Nemus-Project/haptic-harpsichord-nime-2025/src/article.tex

\section{Introduction}\label{introduction}

Technological advances have transformed how museums document, present and
interpret their collections. Immersive experiences are realised through tools
such as 3D printing and virtual reality
\cite{allard2005use,Wachowiak01082009,RCM_2024_3D,Kuzminsky_LaserScan_2012,Schaich_3D_2007}.
These technologies form a kind of experiential authenticity, enabling encounters
that evoke the past's sensory, emotional, and intellectual essence
\cite{trant_Auth_1999}. However, as Pine and Gilmore note
\cite{pinegilmore_2007}, achieving authenticity requires museums to navigate the
delicate balance between preservation and meaningful engagement—a challenge that
is particularly evident in the case of historical musical instrument collections
\cite{McAlpine2014}.

Musical instruments represent a peculiar fusion of form, function, and history.
Their cultural value extends beyond their visual appeal to include the tactile
and auditory dimensions of use \cite{Fritz2017}. Yet, preservation concerns
often limit direct interaction, reducing these artefacts to static displays.
This ``red velvet cord'' approach, as theorised by McAlpine \cite{McAlpine2014},
protects fragile mechanisms but diminishes the instruments’ functional identity,
disconnecting visitors from the full richness of their historical and cultural
context.

The \anon{Tagliavini} Collection in \anon{Bologna \cite{Tagliavini2007}}, housed
at \anon{Museo San Colombano - Genus Bononiae} and renowned for its historical
keyboard instruments, exemplifies this dilemma. With over fifty early keyboard
instruments, primarily early plucked stringed keyboards of Italian origin, the
collection stands out as a valuable resource for musicologists, organologists
and musicians alike. Preserving the instruments' authenticity was the
cornerstone of \anon{Ferdinando Tagliavini}’s vision. This guiding principle led
him to collect instruments that could be restored to their playing condition
after minimal intervention.

However, the delicate mechanisms of these instruments and their historical
significance mean they are only played under strict conditions—by experienced
historical keyboard performers or young musicians under strict supervision from
the curator. To enhance accessibility and engagement, the museum commissioned
the replica (Figure \ref{fig:teaser}) of a historical keyboard built in the
tradition of the Italian school, which is the subject of this paper.
The keyboard targets all visitors to the museum, regardless of playing ability,
and can be used without special permission. Jacks that pluck two choirs of muted
strings, across 49-keys, are used to generate MIDI messages that are sent to a
connected computer for audio synthesis. The interface is presently linked to a
commercial software sampler; however, the ultimate aim is to make the sound of
instruments in the collection that can no longer be maintained in playable
condition accessible. Museum visitors are invited to play the interface and
listen through a pair of headphones. This work outlines the technological
aspects of the interface's construction and offers reflections on its role
within the \anon{Tagliavini} Collection and potential application within the
wider musical instrument museum context.

\section{Related Work and Motivations}\label{related-work}

Museums face a constant tension between accessibility and preservation,
restricting how visitors can interact with collections \cite{Templeton2018,
McAlpine2014}. For musical instrument museums, these challenges are compounded
by the difficulty of preserving historical instruments in a playable condition
\cite{McAlpine2014}. The instruments' inherent fragility and gradual decay
inevitably result in a point where they can no longer be played, even when
collections adhere to the strictest conservation protocols \cite{NYT_strad}. A
marked cultural change has taken place in recent decades, shifting the focus
from the playability of the originals to their conservation. Karp
\cite{Karp1979,Karp1985} advocates for a deeper understanding of musical
instruments so that enough knowledge is generated to make them as ``copyable''
as possible.

As part of a broader initiative to enhance accessibility in museums, \anon{the
Museo San Colombano - Tagliavini Collection}, within the cultural itinerary of
\anon{Fondazione Carisbo}, has developed a series of projects aimed at improving
cognitive and sensory access, supported by funding from NextGenerationEU. The
project seeks to leverage the museum’s collection of musical instruments to
create an immersive and interactive engagement with the exhibited heritage. The
reinterpretation of historical musical objects through their tactile and
auditory dimensions is intended to make the exhibition more accessible to blind
and partially sighted visitors. The augmented keyboard aligns with these
objectives, serving as an important component of the initiative to provide
visitors of varying abilities with a hands-on, creative experience within the
museum.

McAlpine discusses a case similar to the \anon{Tagliavini} collection in his
examination of the Benton Fletcher Collection at National Trust Fenton House
\cite{McAlpine2014}. When these instruments were donated, Benton Fletcher
stipulated that they remain playable and should continue to be maintained for
tuition and public performance. A large sampling campaign was conducted, and a
custom MIDI interface was designed to fulfil this requirement while preserving
the original instruments' integrity. The MIDI controller, comprising two
commercially available keyboards mimicking the two-manual harpsichord layout,
was used by visitors to trigger the instrument samples recorded with tailored
strategies for each. However, user tests identified a limitation: the
commercially available weighted keys failed to provide an authentic sense of
interacting with a historical plucked keyboard instrument \cite{McAlpine2014}.

On the other hand, the ``Tromba Moderna'' project \cite{Baldwin2016}, a previous
NIME initiative, approached the issue of musical heritage playability by
recreating and augmenting a replica of a historical tromba marina. A piezo
transducer was connected to a sound synthesis engine and a driver within the
instrument to simulate the expected vibrations of a historical tromba marina.

The keyboard presented here inherits some aspects from the Tromba Moderna
project. The project aims to offer a tool to enhance the visitor experience of
the \anon{Tagliavini} collection while retaining a form of continuity with
historical instrument-building traditions. However, the electronics hidden
inside the interface are not intended to augment or disrupt the tactile
feedback; rather, they serve as the silent and invisible link between the
mechanical and the digital realms.

The optical sensing technique for the keyboard is adapted from a similar project
on the piano by McPherson \cite{McPherson2013}. As such, this project extends
the longevity of the results beyond the scope envisaged in the original works,
enhancing their sustainability, as discussed by Masu \emph{et al.}
\cite{Masu_NIME_2023}. The intended use of the keyboard through meaningful
interaction with a museum exhibit is where the novelty of this work lies, rather
than solely in its technological development.

Besides enhancing the visitor experience, future design iterations will serve as
a research tool to explore the unique characteristics of the harpsichord and its
impact on performance through the \anon{ERC-funded NEMUS} project
\anon{\cite{NEMUS}}, aiming to virtually reproduce the sound of antique keyboard
instruments, and upcoming projects such as Rem@ke \cite{remake1} investigating
embodied relationships between instrument and performer.

\begin{figure*}
  \centering
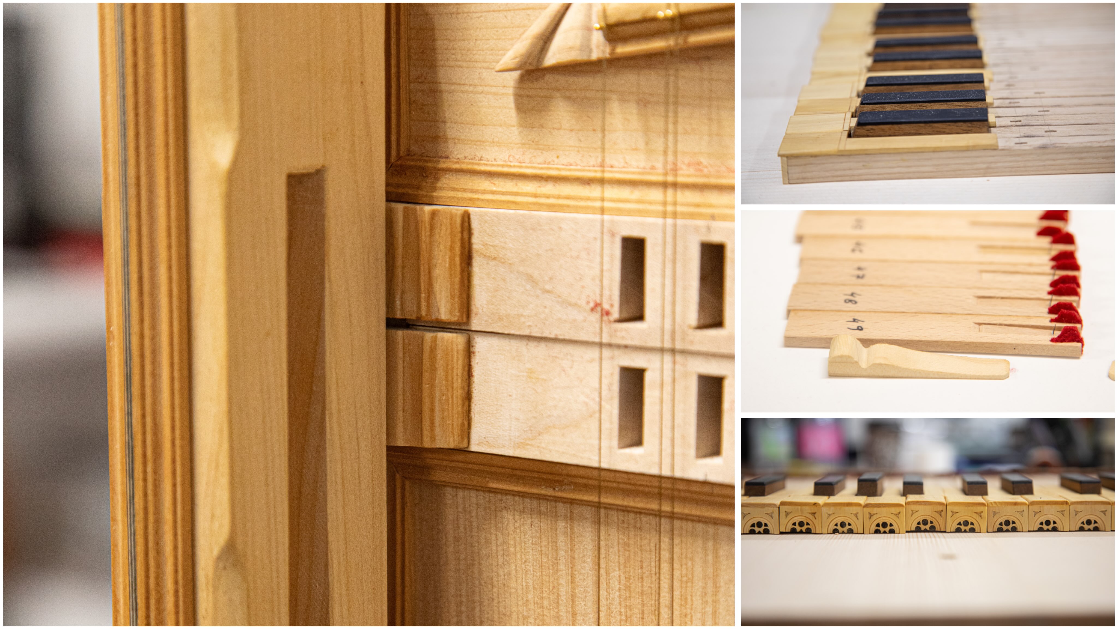
[picture p12: src/images/details.jpg]
  
  \caption{Details of the replica, including the key slots and sides, keys, and jacks with seagull plectra.}
  \Description{4 images contain details of the jack rows. A large image shows
    the end of the jack rows where an extrusion is put to allow jack rows to be
    disengaged. The smaller images show the keys and jack removed from the
    harpsichord exposing the materials from which they are constructed. Shown also
  is the shims for the jack which stop it from easily sliding.}
  \label{fig:details}
\end{figure*}

\section{Design Principles}\label{design}

The design of the augmented replica keyboard for the \anon{Museo San Colombano -
Genus Bononiae} was guided by three principal constraints stipulated by the
museum:

\begin{itemize}
  \item \emph{Faithfulness}. The keyboard mechanism had to ensure fidelity to
    its authentic operation. The electronics system would not seek to `fix' or
    `improve' the limitations of the original design.
  \item \emph{Robustness and reliability}. The system needed to accommodate
    frequent use by museum visitors and allow for straightforward maintenance by
    staff without requiring specialised technical expertise.
  \item \emph{No visible electronic components}. To preserve the visual
    integrity of the exhibit, all electronic components had to remain concealed
    except for a pair of headphones and a small display for audio parameter
    adjustments.
  \item \emph{Reduced use of space}. As museums often face space limitations,
    the instrument needed be compact enough not to compromise space for exhibition
    of the permanent display.
\end{itemize}

These constraints demanded an electronics system that was non-invasive in design
and respectful of the instruments' historical aesthetics. The requirement for
faithfulness to the original mechanism immediately ruled out a mechanical design
reliant on electromechanical actuators, as in previous works on piano haptics
\cite{Timmermans2020,Gillespie1996}. While actuators can generate considerable
force, achieving a jack's free motion and resistance is difficult without
extensive mechanical intervention such as that carried out by Gillespie
\cite{Gillespie1996}.

The final design, shown in Figures \ref{fig:teaser} and \ref{fig:details}, is a
49-key, two-register harpsichord keyboard replica. Since the \anon{Tagliavini
collection} hosts primarily early plucked stringed keyboards of Italian origin,
the keyboard layout was deliberately modelled after early Italian harpsichords,
leveraging the human tendency to be influenced by visual elements when making
musical judgments \cite{Tsay2013}. This effect is particularly relevant in
musical instruments, as demonstrated by studies conducted by Fritz \emph{et al.}
\cite{Fritz2012, Fritz2014, Fritz2017}. Instead of attempting to mitigate this
influence, the design embraces it. This phenomenon, akin to a `musical
instrument McGurk effect’, is one of the reasons why the electronics have been
concealed from view. The aesthetics of the interface enhance its likelihood of
being perceived as an `authentic' musical instrument. Given the extensive
research into modelling and recreating piano action \cite{Cadoz1990,
Gillespie1996, Timmermans2020}, the visual component may provide the final
persuasive element necessary for acceptance, similar to the way visual
perception affects judgments of musical performance \cite{Tsay2013}.

\begin{figure}[!b]
  \centering
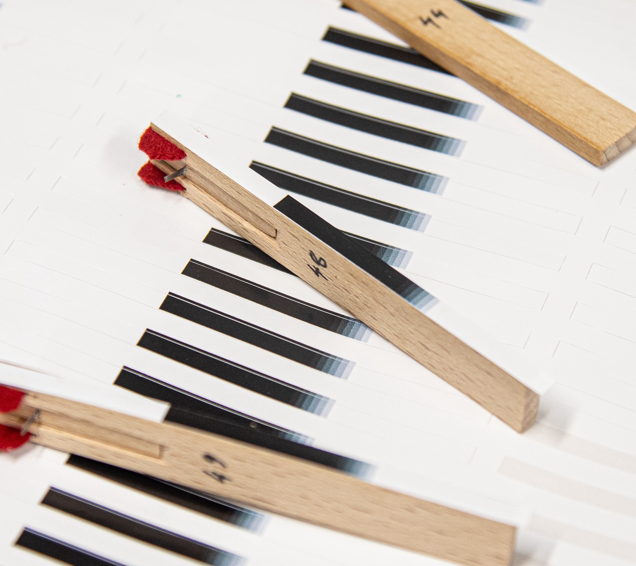
[picture p13: src/images/tagging-jacks-3.jpg]
  
  \caption{Gradient stickers applied to the side of the jack body. The coarse gradient scale was selected to maximise signal excursion while preserving signal readout stability.}
  \Description{Close of two jacks with gradient stickers applied to each. Both
    jack lie on top of the vinyl sheet that was used for printing. The gradient is
    a long black bar that terminates in 7 rectangles of grey over an 8 millimetre
    span. The remainder of the sticker is white. The jacks have the numbers 46 and
    49 written on them at different offset illustrating the numbering system to
  identify their position along the keyboard.}
  \label{fig:jack-tags}
\end{figure}

Optical sensors are positioned in front of each jack and their output voltage
depends on the amount of light reflected from a sensor surface. In this case,
the sensor surface is a grey-scale gradient printed on a vinyl sticker (Figure
\ref{fig:jack-tags}) and applied to the side of each jack. Though the current
configuration simply sends MIDI note-on and -off messages when passing a
threshold, the displacement of all jacks is available continuously. The jacks
for a single key typically have their pluck points offset from each other, a
practice known as `staggering'. A combination of string tension, quill voicing,
and jack staggering contribute to the overall resistance of the action, with
each key differing from the low to the high octaves \cite{Veroli2012}. The
staggering of the pluck point of the jacks between registers means that there
are two distinct tactile anchors along the key dip. The current sensor system
enables the data recording of traditional use from which it can be identified
where those opportunities for new expression lie \cite{McPherson2013-2}.

\begin{figure}
  \centering
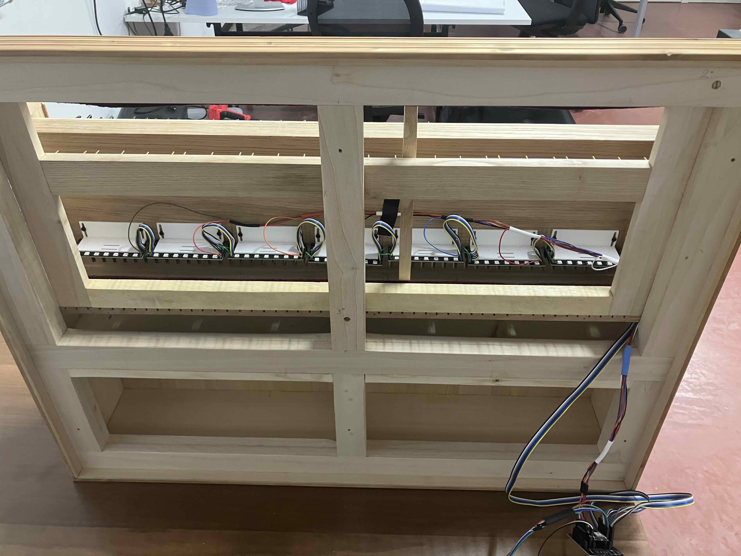
[picture p14: src/images/49-key-bottom-sensors-no-keys.jpg]
  
  \caption{Underside of the full model keyboard, showing two chambers: the front chamber (top) and the rear chamber (bottom).}
  \Description{Underside view of the models with keys removed. A cross brace
    split the case into four quadrants the top two are the front chamber and the
    bottom are the rear chamber. Visible inside are the PCB which are connected to
    each other with multicoloured ribbon cable. From the right 2 long cables, one
    for sensor signals the other for LED and multiplexer signals. Both sets of
    cables terminate at the controller board. The PCBs are attached with white
    plastic supports to the underside of the wrest plank, a thick block of wood in
  which the tuning pegs are screwed.}
  \label{fig:49-key-bottom}
\end{figure}

A modular system of printed circuit boards (PCBs) was designed to manage the
sensors and process their output. The system uses 49 optical sensors distributed
across seven boards containing 7 sensors each. The PCBs were secured to the
underside of the wrest plank and above the keys (Figure
\ref{fig:49-key-bottom}), allowing them to be adjusted during installation.
Ribbon cables connected the PCBs, providing flexibility during assembly while
maintaining a compact form factor. Additional modifications, including baffles
and adhesive improvements, were made to optimise the reliability of the sensor
system during calibration and use.

The project expanded upon earlier NIME research on generating MIDI messages from
piano keystrokes \cite{McPherson2013}, adapting it to address the specific
characteristics of harpsichords. Whereas the previous design emphasised
continuous gesture tracking, this implementation required discrete key-triggered
data to align with the needs of MIDI-triggered audio playback.

\subsection{Materials and Construction}
The keyboard was designed to replicate the tactile and aesthetic sensations of
playing a historical Italian harpsichord. Traditional materials were used,
including walnut for the wrest plank, chestnut for the key levers, boxwood and
ebony for key covers, and cypress for the case and soundboard. The 98 jacks were
made from beech, fitted with brass springs and natural seagull feather plectra.
The design was inspired by the \anon{1547 Alessandro Trasuntino} harpsichord at
the \anon{San Colombano Museum}, considered one of the first prototypes to have
been conceived with two sets of 8-foot strings. An exception was made for the
short octave --- the assigning of common keys in the first octave instead of a
chromatic scale --- typically found in Italian harpsichords, which was replaced
by a standard octave layout to more easily accommodate the interaction with
commercial sample libraries.

% % Option 2
\begin{figure}[!b]
  \centering
  \begin{subfigure}[h]{0.4\linewidth}
    \centering
    \includesvg[inkscapelatex=false, width = \linewidth]{images/log_harp_outline}
    \caption{logarithmic shape}
    \label{fig:log-harp}
  \end{subfigure}

  \begin{subfigure}[h]{0.4\linewidth}
    \centering
    \includesvg[inkscapelatex=false, width = \linewidth]{images/49-key_outline}
    \caption{rectangular shape}
    \label{fig:rect-harp}
  \end{subfigure}
  \caption{Logarithmic shape of an original \anon{Trasuntino} harpsichord
  contrast with the rectangular shape of the replica} \Description{Line drawing
    of two harpsichord shapes. The top line drawing shows the longer tapering form
    of a full scale instrument if it had the same key layout as the replica. The
    second line drawing is of the replica harpsichord. The line drawing share the
    same scale and it can be seen that the replica is roughly one quarter the
  depth of a full scale instrument.}
  \label{fig:log-harp-comp}
\end{figure}

The rectangular poplar frame also deviates from the traditional logarithmic
(Figure \ref{fig:log-harp-comp}) form to allow for the installation of the
electronic sensors, as visible in Figure \ref{fig:49-key-bottom}, without
compromising the visual or tactile authenticity. Two string choirs, crafted from
yellow brass wire and anchored with wrought iron pins, were tensioned to
replicate authentic plucking resistance. Felt strips were added to dampen
vibrations. The result is an interface that combines the mechanical action of
keys with synthetic sound generation, preserving a real harpsichord's tactile
qualities.

\begin{figure}[!t]
  \centering
  
  \caption{ 3-Key Model Harpsichord Mechanism
    %acquired from \anon{San Colombano, Bologna}, 2023.
  } \Description{Side view of a small model mechanism of a harpsichord. The
    model is cut as though it were a cross section of a harpsichord mechanism. The
    Instrument is not to scale and only has a small sound board. Visible are the
    pivots through which the keys are mounted and how the two sets of jack rest on
  the end of the key.}
  \label{fig:3key}
\end{figure}

\subsection{Project Deployment}

A further objective, set forth by the authors, was to ensure reproducibility by
committing to an open source approach for all outputs of the project. The
commitment to open sourcing encompassed all aspects of the system, including
hardware schematics, firmware, and calibration data. Cost-effectiveness was also
a central consideration.
Specifically, the system was designed to be easily assembled using resources
typically available in a university-managed maker space. Components, such as
QRE1113 optical sensors and CD4051BE multiplexers, are widely available from
commercial resellers, while the modular PCB design ensures easy replication and
maintenance. The Arduino Nano was chosen as the core microcontroller format for
its compatibility with open source tools. Calibration workflows were optimised
using the Arduino IDE’s serial plotter and open source MIDI Monitor software
\footnote{\url{https://github.com/krevis/MIDIApps}}, reducing reliance on
proprietary tools and simplifying the process for users.

\begin{anonsuppress}
  Reference repositories for this project can be found here:

  \begin{itemize}
    \item
      \emph{Firmware}:
      \anon{\url{https://github.com/Nemus-Project/harpsichord-interface-firmware}}
    \item
      \emph{PCB CAD}:
      \anon{\url{https://github.com/Nemus-Project/harpsichord-interface-cad}}
    \item
      \emph{Interface Models}:
      \anon{\url{https://github.com/Nemus-Project/harpsichord-interface-models}}
  \end{itemize}
\end{anonsuppress}

\section{Hardware Design}\label{hardware-design}

Figure \ref{fig:system-block-diagram} shows a block diagram of the finalised
hardware setup. The system evolved through iterative prototyping, beginning with
simple threshold-based testing and ending in a fully functional multi-sensor
interface capable of triggering MIDI events.

\subsection{Prototype Stage}

The initial stage of development focused on testing whether sensor data could
reliably trigger MIDI playback. Modifying an existing harpsichord for testing
was considered but ultimately discarded due to significant internal measurement
and layout discrepancies. Instead, a custom 3-key harpsichord mechanism (Figure
\ref{fig:3key}) was used as a foundation for prototyping. This approach followed
a methodology similar to that used in Timmermans \emph{et al.}'s Haptic Key
project \cite{Timmermans2020}, since the 3-key model enabled iterative testing
of individual components, including sensor placement, signal processing, and
mechanical tolerances, before upscaling.

The following criteria were established to guide sensor selection and
integration to make the system suitable for a museum context:

\begin{itemize}
  \item \emph{Non-invasiveness:} No remarkable modifications were allowed on the
    harpsichord mechanics, particularly on all the visible parts.
  \item \emph{Low Latency:} The sampling period for reading and processing data
    from all sensors should remain under 10 ms to allow for latency introduced in
    other parts of the synthesis process. Empirical criteria found in previous
    studies \cite{Jack2016} was used as a guide.
  \item \emph{Reliability:} Sensor data should be dependable and consistent,
    with interference from anything external to the jack movement being absent or
    negligible.
  \item \emph{Scalability:} The design needed to scale in both cost and time in
    order to be adaptable from a 3-key prototype (Figure \ref{fig:3key}) up to the
    49 keys of the final design.    
\end{itemize}

The hardware was designed to make assembly possible in standard university maker
spaces.

\subsection{Sensor Board}\label{sensor-board}

\begin{figure}[!b]
  \centering
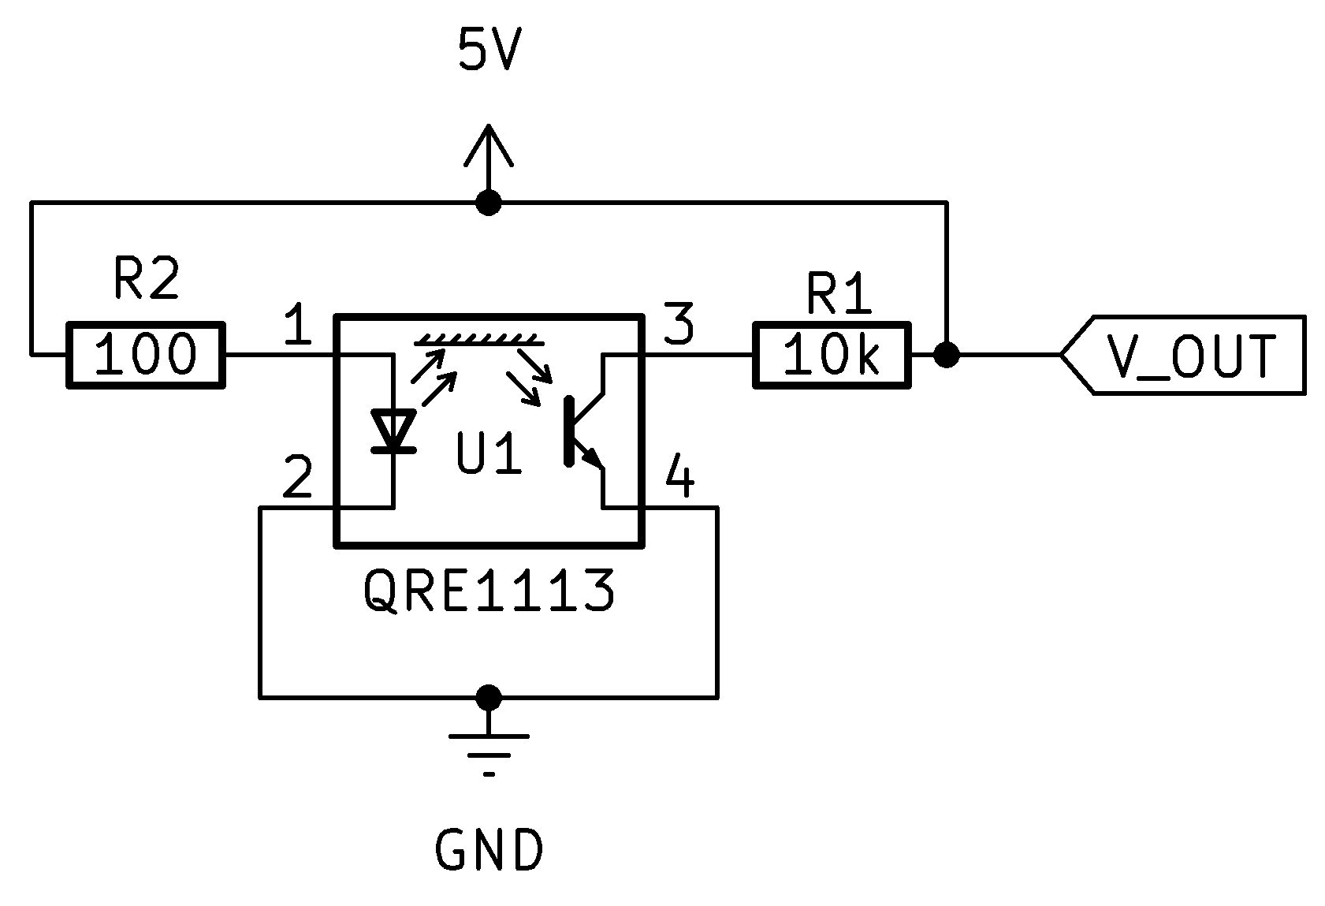
[picture p15: src/images/simple-schematic-bw-.jpg]
  
  \caption{Optical sensor in a simple voltage divider circuit. \texttt{V\_OUT}
  is routed to one of 8 channels on the CD4051BE multiplexer.} \Description{A
    circuit diagram of a voltage divider circuit. The Image shows a 100 ohm
    resistor in line with the LED and a 10 thousand ohm resistor connected to the
    emitter of the phototransistor and the collector connected to ground. The line
    to the bisects before the 10 thousand ohm resistor to a label titled V OUT.
    Arrows from the LED illustrate how light controls the base of the
  phototransistor.}
  \label{fig:simple-schematic}
\end{figure}

The final sensor system utilised QRE1113 optical sensors, known for their small
form factor, low cost, and suitability for short-range distance detection
\cite{McPherson2013, McPherson2019}. The sensors were distributed across seven
printed circuit boards, each responsible for seven keys. Each PCB contained the
following components:

\begin{itemize}
  \item 7 QRE1113 optical sensors.
  \item 7 100 $\Omega$ resistors and 7 10 k$\Omega$ resistors (later reduced to
    one resistor per board).
  \item 1 Texas Instruments CD4051BE multiplexer for signal aggregation.
  \item 7 WS2812 RGB LEDs with integrated driver.
\end{itemize}

\begin{figure*}
  \centering
  
  \caption{Block diagram of PCB connections. A separate sensor signal is routed to the Arduino. LED and multiplexer (MUX) controls signal are daisy-chained through each sensor PCB.}
  \Description{The block diagram shows seven blocks each with sensor board
    written on them. Each sensor block has a solid arrow which connects to a block
    labelled Arduino Nano 33 BLE. A dashed arrow is drawn from the Ardnuino Nano
    33 BLE box and travels through each sensors board. A legend shows the solid
    line represents the flow of the sensor signal and the dashed arrow the flow of
    LED an multiplexer control signals. Angled arrows from the sensor board point
    towards and away from a hatched lined representing the surface of the jacks,
    which illustrates the reflection of light. Lines from boxes labelled FRAM and
  Rotary Encoder point to and from the box labelled Arduino Nano 33 BLE.}
  \label{fig:system-block-diagram}
\end{figure*}

The optical sensors are wired in a voltage divider configuration (Figure
\ref{fig:simple-schematic}) and the circuit outputs a voltage based on the
infrared light reflected from nearby surfaces. The gradient stickers affixed to
each jack provided a surface with varying reflectivity for the sensors, which
were used to track jack displacement throughout the key dip.

\begin{figure}[!t]
  \centering
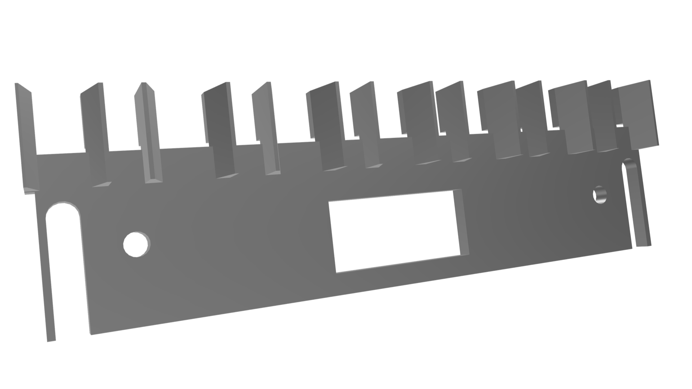
[picture p16: src/images/baffles.png]
  
  \caption{Baffles designed to prevent cross-talk between adjacent sensors.}
  \Description{A 3D model of the baffles used to reduce light leakage. Two slots
    are on the left and right sides. Two holes are visible beside each slot,
    through which the baffles can be attached to the PCB. A rectangular cutaway is
    visible for the multiplexer chip. The baffles contained14 angled extrusions 2
  for each sensor.}
  \label{fig:baffles}
\end{figure}

3D-printed baffles were installed on the PCBs to eliminate cross-talk between
adjacent sensors, as per Figure \ref{fig:baffles}. These baffles, fabricated
from dark-pigmented PLA, ensured that infrared reflections from neighbouring
jacks did not interfere with sensor readings. A manual visual check of plotted
all sensors readings confirmed that interference from neighbouring jacks had
been eliminated. RGB LEDs are placed on the reverse side of the PCB, vertically
in-line with the sensors, and were added to provide a programmable means of
providing visual feedback. The LEDs are controlled via a pulse width modulation
(PWM) signal and are addressable individually. The output signal of the
multiplexer is taken from each PCB and routed to a separate ADC channel of the
Arduino. Multiplexer channel select and LED PWM signals are daisy-chained
through each PCB (Figure \ref{fig:sensor-reverse}).

\subsection{Controller Board}\label{controller-board}

The controller board, designed around the Arduino Nano format, was the central
hub for processing sensor data and triggering MIDI messages. In addition to
solder terminals for the sensor board channels, the controller board contained:

\begin{itemize}
  \item 1 Arduino Nano 33 BLE.
  \item 1 Fujitsu MB85RS64 SPI Ferroelectric RAM chip.
  \item 1 EC11 combined rotary encoder and tactile switch.
    % \item 1 DFROBOT DFR0785 Tactile Switch
\end{itemize}

The Arduino Nano's small form factor made fitting the board inside the
harpsichord easier and also allowed for testing of multiple chipsets. The 33 BLE
variation of the Nano had the additional benefit in its ability to be programmed
as both native USB MIDI and BLE MIDI devices. The 33 BLE was also able to
achieve a sampling period of 1.7 milliseconds for all sensors. A 4-sample moving
average filter was implemented to reduce noise and brought the effective
sampling period to 5.1 milliseconds.

Non-volatile memory, implemented using a Fujitsu MB85RS64 Ferroelectric RAM
(FRAM) chip, provided a reliable means of storing and preserving calibration
settings across power cycles. This ensured that sensor thresholds and other
settings could be preserved across power cycles, enhancing the system's
usability in museums.

A rotary encoder was used as the interface to select a key, edit a threshold and
save current thresholds to the FRAM. Thresholds were first set the midrange of
possible values a a default. A rough calibration process was carried out where
each sensor were selected individually and its readings were plotted against
their current threshold value using the Arduino IDE serial plotter. Thresholds
were adjusted with the rotary encoder until the key no longer passed the
threshold line until the jack had plucked the string. During calibration RGB
LEDs were used as a visual aid to quickly identify which key was currently being
adjusted. These LEDs also provided visual feedback during calibration, and would
change colour based on if readings were above below the threshold or if the were
outside previously recorded maximum or minimum values. Such use of the LEDs
meant for easy identification of malfunctioning sensors and simplified the
alignment process. A finer calibration process was carried out with the guidance
of expert harpsichord performer \anon{Catalina Vicens}.

Power requirements for the system were estimated at 1.1 A at 5 V, with some
fluctuation when the system was first powered on. While the sensors were powered
continuously in this iteration, future designs may incorporate power-saving
measures, such as dynamic modulation of the optical emitters found in the
McPherson piano \cite{McPherson2013}.

\begin{figure}[!b]
  \centering
  
  \\
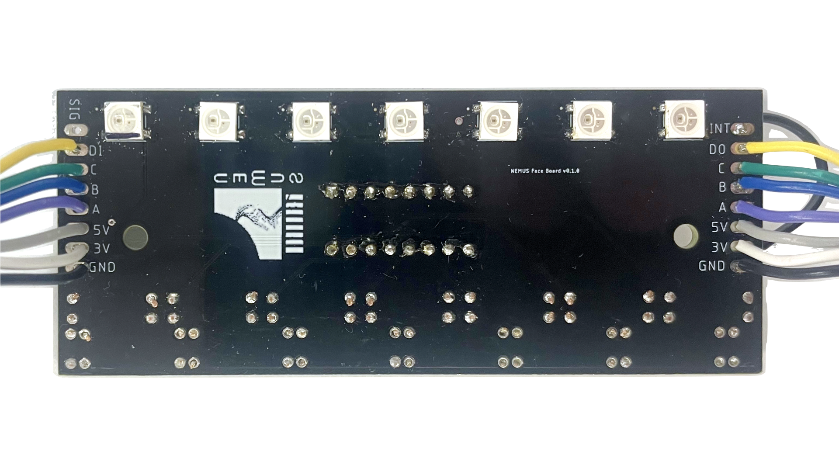
[picture p17: src/images/sensor-board-reverse-side.png]
  
  \caption{Sensor board showing the sensor side (top) and rear side with RGB
    LEDs and terminal connections (bottom). The \texttt{SIG} terminal (Top Left)
    is routed to an ADC channel. Power \texttt{5V, 3V, GND}, multiplexer channels
    \texttt{A, B, C} and LED PWM input \texttt{DI} and output \texttt{DO}  connect
  from the previous sensor board (Left) and are routed to the next (Right).}
  \Description{Two images one of the front and one of the rear of a single
    sensor board. The top image shows the baffles in place and how they enclose
    the field of view of each sensor. The bottom image shows the wires from
    neighbouring circuit boards terminating and the line of 7 RGB LEDs in the same
  spacing as the LEDs.}
  \label{fig:sensor-reverse}
\end{figure}

For the initial version of the exhibition, a harpsichord sample library was used
and controlled via Native Instrument's
Kontakt\footnote{\href{https://www.native-instruments.com/en/products/komplete/samplers/kontakt-8/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}{Kontakt
webpage} (accessed 31 Jan 2025)}. The software was installed on a Mac Mini
hosted inside the instrument's case. Holes were drilled at the back of the
instrument's frame, away from sight, to allow the passage of cables, such as
from power supplies, USB connectors and headphone jack (Figure
\ref{fig:mac-mini}). An iPad is used as a monitor through which visitors can
adjust playback parameters such as tuning, voicing and which stops are engaged.

\begin{figure}
  \centering
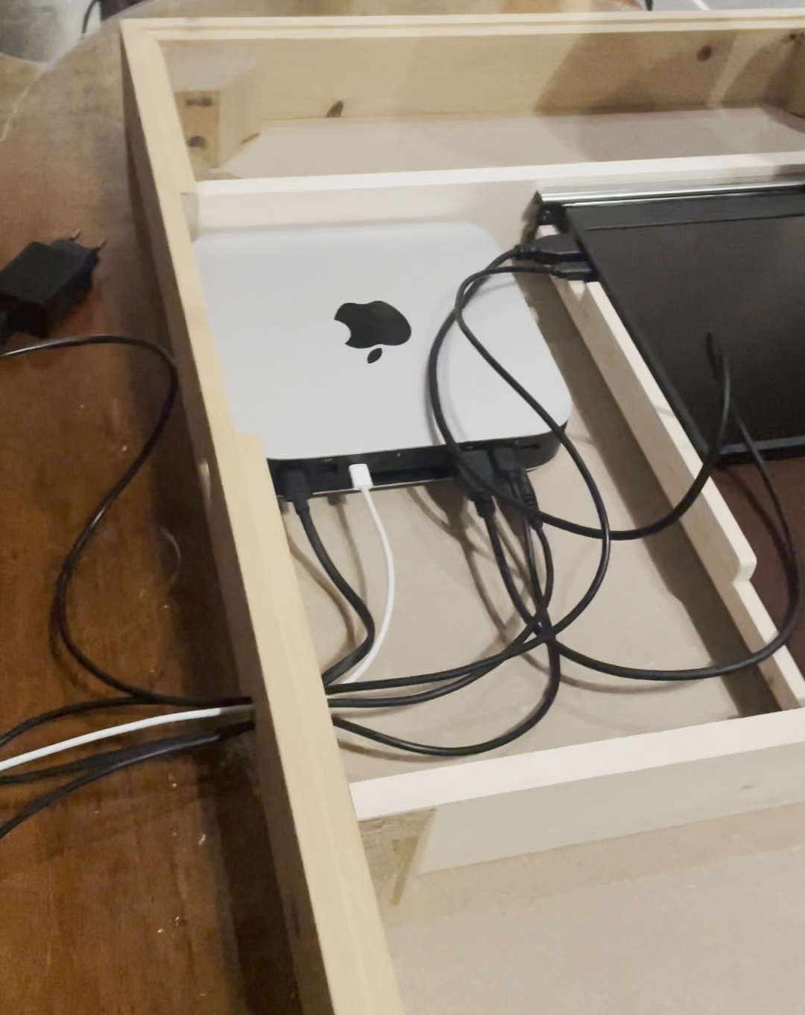
[picture p18: src/images/mac-mini.jpg]
  
  \caption{Components and cabling hidden in the bottom section of the instrument case.}
  \Description{The mac mini and its display fitted in a shallow draw with a
    channel drilled in the end through which cables can be connected. The draw has
  dividers in place to separate the mac mini from the display.}
  \label{fig:mac-mini}
\end{figure}

\section{Discussion}\label{context}

The exhibition is set to open approximately a month after this work's
submission, and only preliminary feedback has been collected from a pool of 20
people -- consisting of staff, surveillance personnel and visitors who were
given training on the system -- and expert feedback from \anon{Catalina Vicens}
and \anon{Roberto Livi}. Visitor feedback was collected through short informal
interviews and primarily to identify technical problems. The keyboard shows
promise in enhancing the museum experience as comments about a ``sense of
disconnect'' found in the Benton Fletcher Collection \cite{McAlpine2014} were
absent in this initial feedback.

A more formal surveying of museum visitors would be required to determine to
what degree the exhibition achieved its core aims. The keyboard is hosted in the
\emph{Oratory} above the museum's main hall, an exceptional testimony to the
Bolognese art, decorated by the finest students of the Carracci and presenting a
series of frescoes covering most of the walls and ceiling. The room hosts unique
examples of the Italian Renaissance building tradition, including the 1547
harpsichord and the 1540 spinet by \anon{Alessandro Trasuntino}. Visitors often
visit the room with the same caution and respect typical of worship spaces.
Among the visitors interviewed, no comments were made that the exposed
headphones and touchscreen affected such an experience negatively, though a more
definitive answer will come as more feedback is collected after launch. Pictures
of the keyboard hosted in the \emph{Oratory} are shown in Figure
\ref{fig:oratory}.

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

\begin{figure}
  \centering
  
  \caption{The keyboard installed in the \emph{Oratory} at \anon{San Colombano},
  and a user wearing headphones playing it.} \Description{2 images on showing
    the keyboard in situ in the museum and the second a user playing the keyboard.
    The harpsichord placed on top the drawer in which the mac mini and display
    reside. The whole harpsichord unit is positioned on a table. The right image
    shows a user standing playing the keyboard with a display for the exhibition
  visible in the background.}
  \label{fig:oratory}
\end{figure}

This work has incorporated and developed further the ideas of reusing and
complimenting the `old' in digital musical instrument design as put forward in
the article `The \emph{O} in NIME' \cite{Masu_NIME_2023}. By integrating
historical keyboard-building traditions with digital augmentation, it offers a
possibility to extend the practical lifespan of musical heritage while
maintaining the tactile qualities of the original instrument. Rather than
prioritising technical novelty, the project demonstrates how digital
interventions can support multi-modal interaction with a shared musical
heritage, ensuring its continued relevance in contemporary museum contexts.

A longer discussion, but one going beyond the scope of this work, is whether the
current setup or its future iterations may be effectively used to build
legitimate replicas of historical musical instruments or even become a kind of
\emph{new} musical instrument altogether. As such, the question is whether these
designs may result in music being practised, performed and recorded with the
instruments. This work supports an overarching narrative extending beyond its
application in museum collections. The \anon{NEMUS project \cite{NEMUS}},
focusing on developing advanced physical models simulating the non-linear
interaction between subcomponents, has commissioned a second keyboard to further
explore the role of control interfaces in performance, employing the sense of
touch as link between the mechanical world with the digital, replicating the
embodied relationships between performer and instrument and offering
opportunities to modify or even disrupt these interactions. The upcoming Rem@ke
project \cite{remake1} has also expressed an interest in engaging with the
keyboard to explore meaningful embodied interactions between players and
instruments.
