Nemus-Project/haptic-harpsichord-nime-2025/src/main.tex

%%
%% This is file `sample-nime-paper.tex',
%% generated with the docstrip utility.
%%
%% The original source files were:
%%
%% samples.dtx  (with options: `all,proceedings,bibtex,sigconf')
%% 
%% IMPORTANT NOTICE:
%% 
%% For the copyright see the source file.
%% 
%% Any modified versions of this file must be renamed
%% with new filenames distinct from sample-nime-paper.tex.
%% 
%% For distribution of the original source see the terms
%% for copying and modification in the file samples.dtx.
%% 
%% This generated file may be distributed as long as the
%% original source files, as listed above, are part of the
%% same distribution. (The sources need not necessarily be
%% in the same archive or directory.)
%%
%%
%% Commands for TeXCount
%TC:macro \cite [option:text,text]
%TC:macro \citep [option:text,text]
%TC:macro \citet [option:text,text]
%TC:envir table 0 1
%TC:envir table* 0 1
%TC:envir tabular [ignore] word
%TC:envir displaymath 0 word
%TC:envir math 0 word
%TC:envir comment 0 0
%%
%%
%% History of NIME Template Updaters:
%% Modified by Florent Berthaut, Charles Martin, Yichen Wang, 21 November 2024
%% Modified by Adnan Marquez-Borbon 30 November 2022
%% Modified by Courtney Reed 28 November 2022
%% Modified by Joe Wright 14 December 2019
%% Modified by Niccolò Granieri 10 October 2018
%% Modified by Angelo Fraietta 23 December 2018
%% Modified by Angelo Fraietta 22 November 2018
%% Modified by Rodrigo Schramm on 22 September 2018
%% Modified by Luke Dahl on 17 October 2-17
%% Modified by Cumhur Erkut on <2016-10-11 Tue>
%% Modified by Edgar Berdahl on 5 November 2014
%% Modified by Baptiste Caramiaux on 25 November 2013
%% Modified by Kyogu Lee on 7 October 2012
%% Modified by Georg Essl on 7 November 2011
%%
%% And here's the template:
%%
%% The first command in your LaTeX source must be the \documentclass
%% command.
%%
%% For submission and review of your manuscript please change the
%% command to \documentclass[manuscript, screen, review]{nimeart}.
%%
%% When submitting camera ready or to TAPS, please change the command
%% to \documentclass[sigconf]{nimeart} or whichever template is required
%% for your publication.
%%
%%
% \documentclass[sigconf]{nimeart}
% \documentclass[sigconf]{nimeart}
\documentclass[sigconf]{nimeart}
\usepackage{graphicx,subcaption,svg}

%%
%% \BibTeX command to typeset BibTeX logo in the docs
\AtBeginDocument{%
  \providecommand\BibTeX{{%
    Bib\TeX}}}

%% Rights management information.  This information is sent to you
%% when you complete the rights form.  These commands have SAMPLE
%% values in them; it is your responsibility as an author to replace
%% the commands and values with those provided to you when you
%% complete the rights form.
\setcopyright{cc}
\copyrightyear{2025}
\acmYear{2025}
\acmDOI{}
%% These commands are for a PROCEEDINGS abstract or paper.
%% Make sure this is up to date with the correct edition of NIME.
\acmConference[NIME '25]{International Conference on New Interfaces for Musical Expression}{June 24--27,
  2025}{Canberra, Australia}
%% This suppresses the ACM Reference Format printing.
\settopmatter{printacmref=false}
%%
%%  Uncomment \acmBooktitle if the title of the proceedings is different
%%  from ``Proceedings of ...''!
%%
%%\acmBooktitle{Woodstock '18: ACM Symposium on Neural Gaze Detection,
%%  June 03--05, 2018, Woodstock, NY}
\acmISBN{}

%%
%% Submission ID.
%% Use this when submitting an article to a sponsored event. You'll
%% receive a unique submission ID from the organizers
%% of the event, and this ID should be used as the parameter to this command.
%%\acmSubmissionID{123-A56-BU3}

%%
%% For managing citations, it is recommended to use bibliography
%% files in BibTeX format.
%%
%% You can then either use BibTeX with the ACM-Reference-Format style,
%% or BibLaTeX with the acmnumeric or acmauthoryear sytles, that include
%% support for advanced citation of software artefact from the
%% biblatex-software package, also separately available on CTAN.
%%
%% Look at the sample-*-biblatex.tex files for templates showcasing
%% the biblatex styles.
%%

%%
%% The majority of ACM publications use numbered citations and
%% references.  The command \citestyle{authoryear} switches to the
%% "author year" style.
%%
%% If you are preparing content for an event
%% sponsored by ACM SIGGRAPH, you must use the "author year" style of
%% citations and references.
%% Uncommenting
%% the next command will enable that style.
%%\citestyle{acmauthoryear}

%%
%% end of the preamble, start of the body of the document source.
\begin{document}

%%
%% The "title" command has an optional parameter,
%% allowing the author to define a "short title" to be used in page headers.
\title{Augmentation of a Historical Harpsichord Keyboard Replica for Haptic-Enabled Interaction in Museum Exhibitions}

%%
%% The "author" command and its associated commands are used to define
%% the authors and their affiliations.
%% Of note is the shared affiliation of the first two authors, and the
%% "authornote" and "authornotemark" commands
%% used to denote shared contribution to the research.
\author{Matthew Hamilton}
% \authornote{Both authors contributed equally to this research.}
\affiliation{%
  \institution{Università di Bologna}
  \city{Bologna}  
  \country{Italy}
}
\email{matthew.hamilton2@unibo.it}
% \orcid{1234-5678-9012}
\author{Michele Ducceschi}
% \authornotemark[1]
\affiliation{%
  \institution{Università di Bologna}
  \city{Bologna}  
  \country{Italy}
}
\email{michele.ducceschi@unibo.it}

\author{Roberto Livi}
\affiliation{%
  \institution{Master Harpsichord Maker}
  \city{Pesaro}
  \country{Italy}
  }
\email{robertvs.livi@gmail.com}

\author{Catalina Vicens}
\affiliation{%
  \institution{Museo San Colombano}
  \city{Bologna}
  \country{Italy}}
  \email{catalina.vicens@genusbononiae.it}

\author{Andrew McPherson}
\affiliation{%
 \institution{Imperial College London}
 \city{London}
 \country{United Kingdom}}
 \email{andrew.mcpherson@imperial.ac.uk}

%%
%% By default, the full list of authors will be used in the page
%% headers. Often, this list is too long, and will overlap
%% other information printed in the page headers. This command allows
%% the author to define a more concise list
%% of authors' names for this purpose.
% \renewcommand{\shortauthors}{Hamilton et al.}

%%
%% The abstract is a short summary of the work to be presented in the
%% article.
\begin{abstract}
% This paper describes the design and creation of an electronically augmented replica of a 16th-century harpsichord keyboard with a typical Renaissance Italian layout to create a digital musical instrument. % [1]
% The tactile feedback of the keyboard is created by incorporating the same mechanics as a single manual two-register harpsichord with strings under tension in order to replicate the mechanical resistance characteristic of the original compass. % [1]
% An optical sensor system was fitted inside the body of the harpsichord, directed towards a gradient surface applied to the body of each jack, generating continuous streams of data corresponding that are used to trigger a sample library. % [1, ~4]
% The keyboard was commissioned for exhibition in a musical instrument museum as an enhancement to the visitor experience by providing means of accessing to instruments that are no longer in playing condition. % [2]
% The details of the keyboard's design principles, technical development, and underlying motivations are described in detail. % [1]
% % The design and mechanics of a harpsichord were replicated in the new keyboard as using modern plastic MIDI controllers has been shown to be an unsatisfying experience for users. % [3]
% % This culminated in a design for a keyboard interface capable of extending the performance techniques of the harpsichord. % [4]

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

\end{abstract}

%%
%% Keywords. The author(s) should pick words that accurately describe
%% the work being presented. Separate the keywords with commas.
\keywords{interactive exhibit, augmented instrument, optical sensing, harpsichord}

%% A "teaser" image appears between the author and affiliation
%% information and the body of the document, and typically spans the
%% page.

% % Option 1:
% \begin{teaserfigure}
%   \includegraphics[width=\textwidth]{images/49-key-front.png}
%   \caption{49-key Model Harpsichord Mechanism by Roberto Livi, Bologna 2024}
%   \Description{49-key Model Harpsichord Mechanism by Roberto Livi, Bologna 2024}
%   \label{fig:teaser}
% \end{teaserfigure}

% Option 2:
\begin{teaserfigure}
 \centering
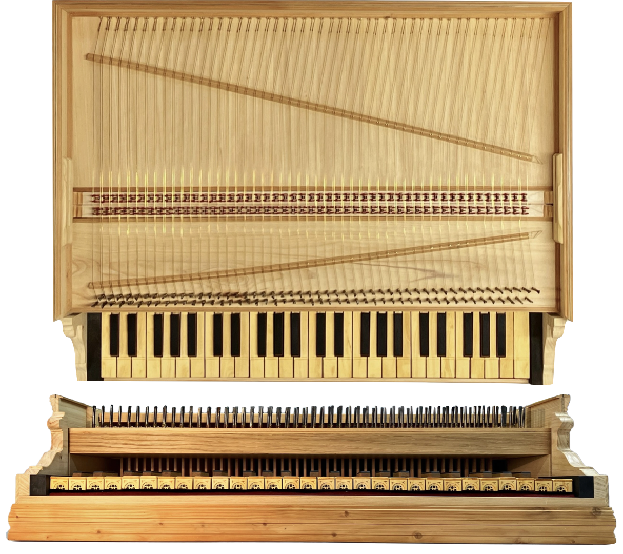
[picture p20: src/images/49-key-front-top.png]
  
  \caption{49-key Model Harpsichord Mechanism by \anon{Roberto Livi, Bologna 2024}}
  \Description{An overhead and front view of the replica harpsichord. The overhead view shows the exposed jacks rows, 49 per row and the slant of the bridge and change of sctring from the left to the right.
The front view shows arch detailing on the edge of each key in the same style as is found on early Italian harpsichords.}
  \label{fig:teaser}
\end{teaserfigure}

% % Option 3:
% \begin{teaserfigure}
%   \includegraphics[width=\textwidth]{src/images/sensors-without-keys-front.jpg}
%   \caption{49-key Model Harpsichord Mechanism by Roberto Livi, Bologna 2024}
%   \Description{49-key Model Harpsichord Mechanism by Roberto Livi, Bologna 2024}
%   \label{fig:teaser}
% \end{teaserfigure}

%% Placeholder
% \begin{teaserfigure}
%   \includegraphics[width=\textwidth]{images/side_w-o_sensors.png}
%   \caption{3-key Model Harpsichord Mechanism by Graziano Bandini, Bologna 2023}
%   \Description{3-key Model Harpsichord Mechanism by Graziano Bandini, Bologna 2023}
%   \label{fig:teaser}
% \end{teaserfigure}

%%
%% This command processes the author and affiliation and title
%% information and builds the first part of the formatted document.
\maketitle

\include{src/article}

%%
%% The acknowledgments section is defined using the "acks" environment
%% (and NOT an unnumbered section). This ensures the proper
%% identification of the section in the article metadata, and the
%% consistent spelling of the heading.

\begin{acks}
The construction of the keyboard received funding from NextGenerationEU within the framework of the accessibility project for the Removal of Physical and Cognitive Barriers in Museums, Libraries and Archives: Sound Heritage No Limits, in the Museum of San Colombano in Bologna - CUP: C38J23000040001 - in the context of PNRR, Mission 1. MH and MD's work was supported by the European Commission's Horizon2020 programme through grant \anon{ERC-StG 950084 NEMUS}. 

 We acknowledge the invaluable contributions of
\begin{itemize}
\item
  Università di Bologna
  \begin{itemize}
  \item
    \emph{Alma Labor}:
      Massimiliano Fraulini and the staff of Alma Labor at the Università
      di Bologna for their 3D printing expertise and generosity with
      electronics equipment
  \item
    \emph{Fisica Tecnica}: Maurzio Chendi, Fabrizio Casarini, Giulio Severo and Barbara
      Costantini    
  \end{itemize}
\item
  University of Edinburgh
  \begin{itemize}
  \item
    \emph{uCreate}:    
      Simeon, Stuart, Izzy, and Ruth of uCreate at the Univeristy of
      Edinburgh for their support with soldering facilities.    
  \item
    \emph{Edinburgh College of Art}: Richard Collins and the Digital Making Staff at the Edinburgh
      College of Art for 3D printing instruction and CNC support. Digital Development Technician Joe Hathaway    
    \item  
      \emph{St Cecilia's}: Curator Dr. Jenny Nex
  \end{itemize}
\end{itemize}

\end{acks}

\section{Ethical Standards}
This work is an empirical study of a keyboard system and
involved no research participants. The authors obtained explicit consent to collect feedback. Seagull feathers, employed as a building material for the jacks, were ethically sourced and collected along the Pesaro coastline. 

%%
%% The next two lines define the bibliography style to be used, and
%% the bibliography file.
\bibliographystyle{ACM-Reference-Format}
\bibliography{main}

\end{document}
\endinput
%%
%% End of file `sample-nime-paper.tex'.
