Nemus-Project/haptic-harpsichord-nime-2025/src/images/outline_compare.pdf

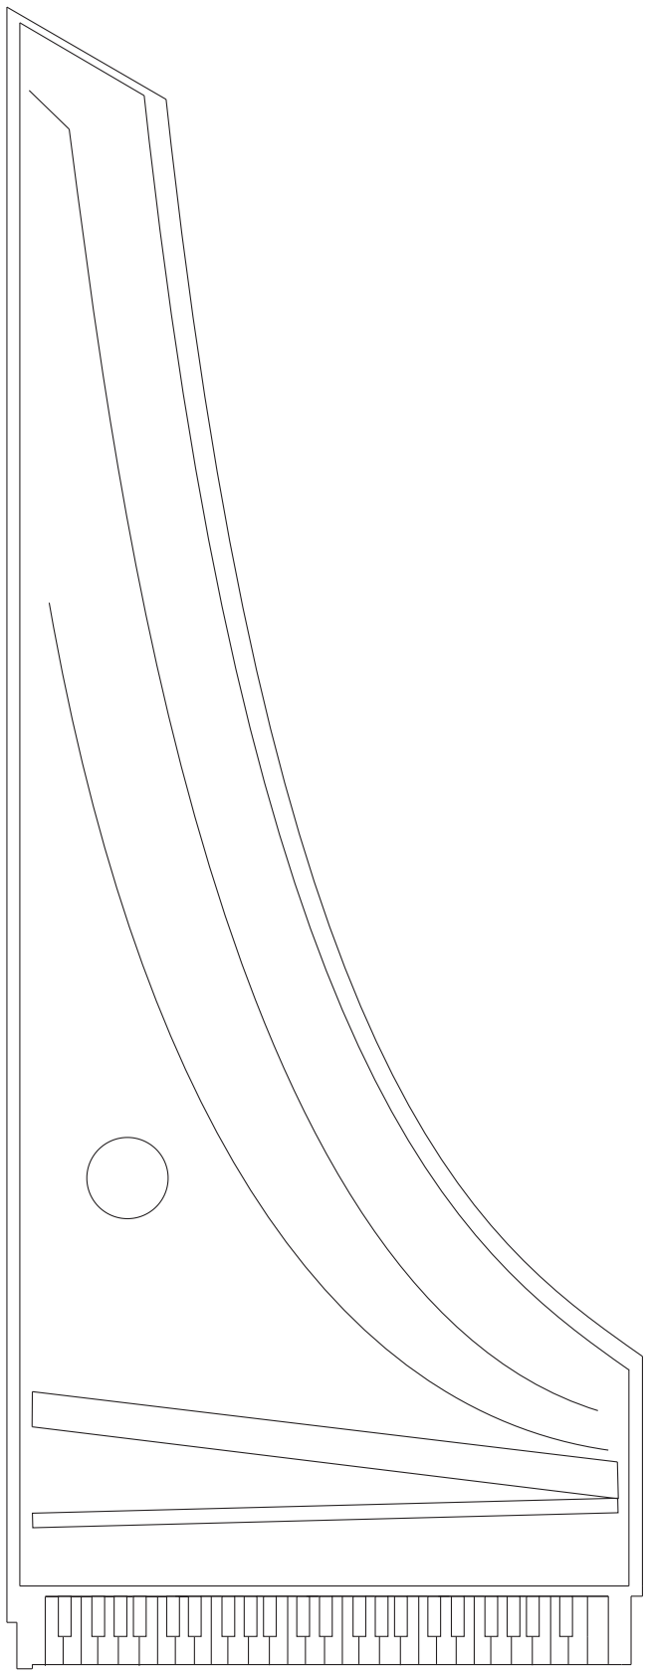
[picture p21: figure]
