Nemus-Project/haptic-harpsichord-nime-2025/src/images/3-key-jacks-w-tags.jpg

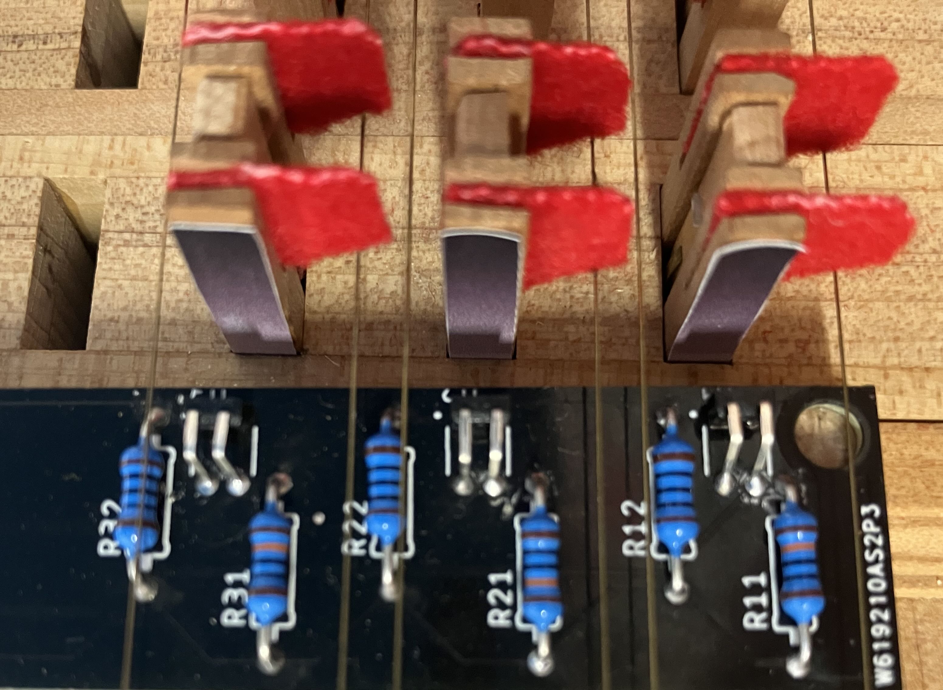
src/images/3-key-jacks-w-tags.jpg
