Nemus-Project/haptic-harpsichord-nime-2025/src/images/3-key-side-labelled.png

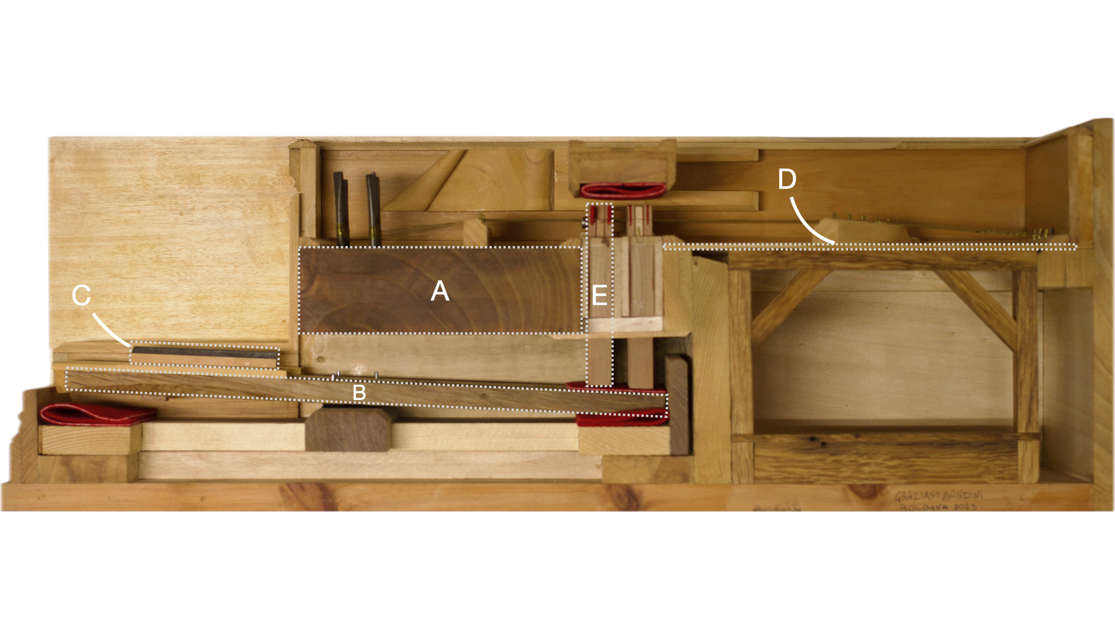
src/images/3-key-side-labelled.png
