Nemus-Project/haptic-harpsichord-nime-2025/src/images/3-sensor-schematic.png

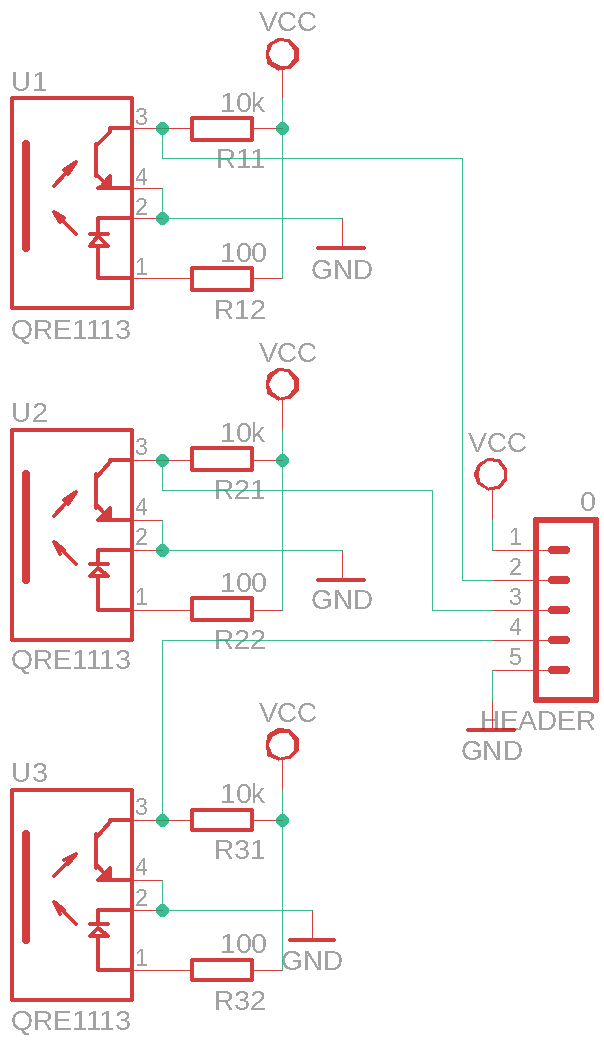
src/images/3-sensor-schematic.png
