Nemus-Project/haptic-harpsichord-nime-2025/src/images/7-sensor-board-v0.1.0.png

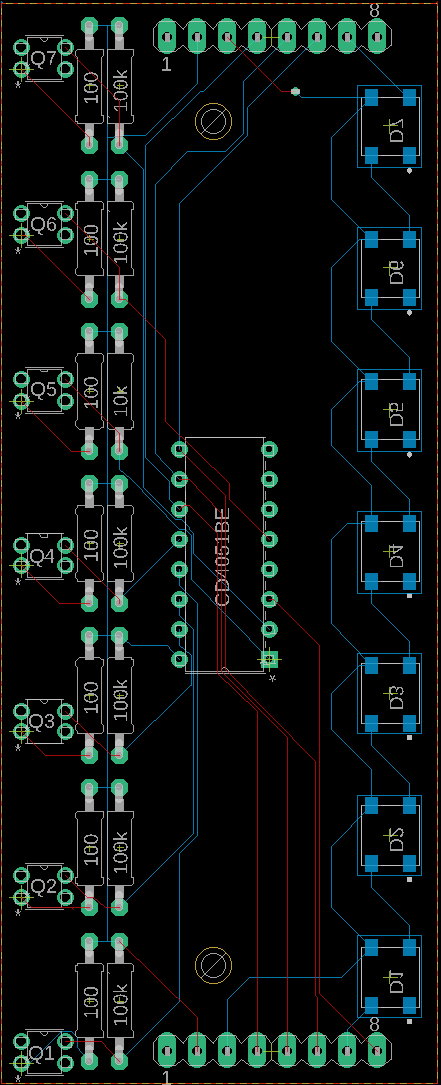
src/images/7-sensor-board-v0.1.0.png
