Nemus-Project/haptic-harpsichord-nime-2025/src/images/49-key-bottom.jpeg

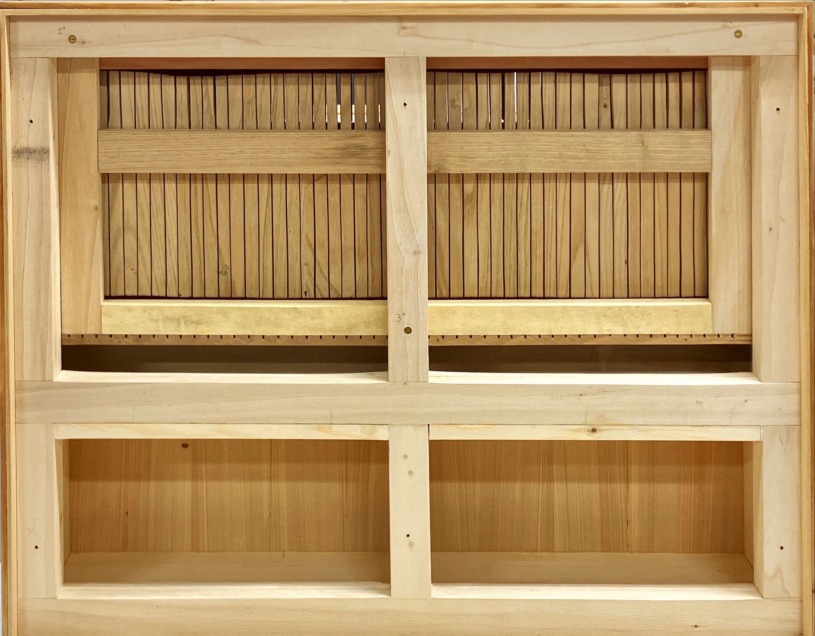
src/images/49-key-bottom.jpeg
