Nemus-Project/haptic-harpsichord-nime-2025/src/images/49-key-front.JPG

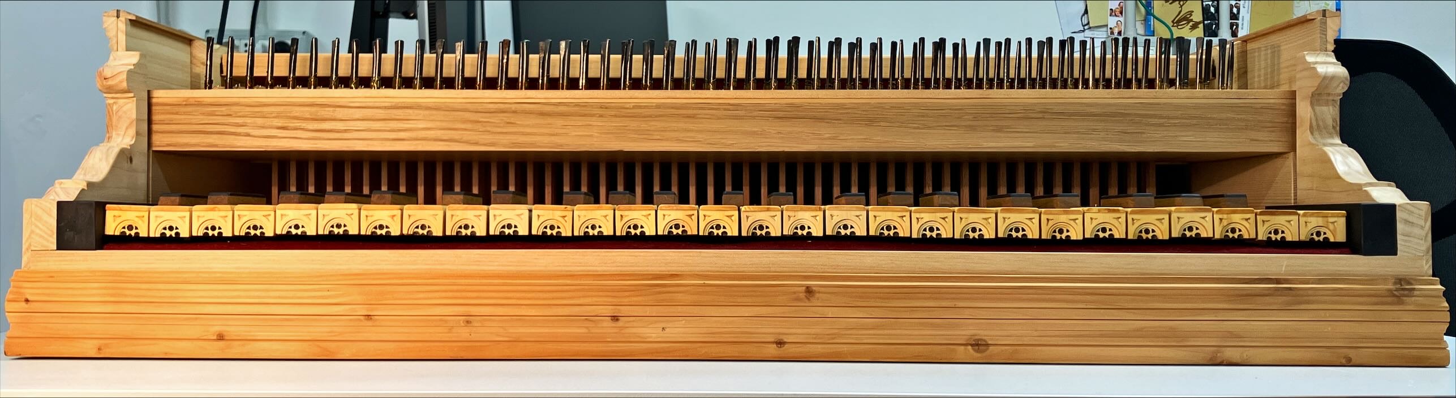
src/images/49-key-front.JPG
