Nemus-Project/haptic-harpsichord-nime-2025/src/images/49-key-leds.png

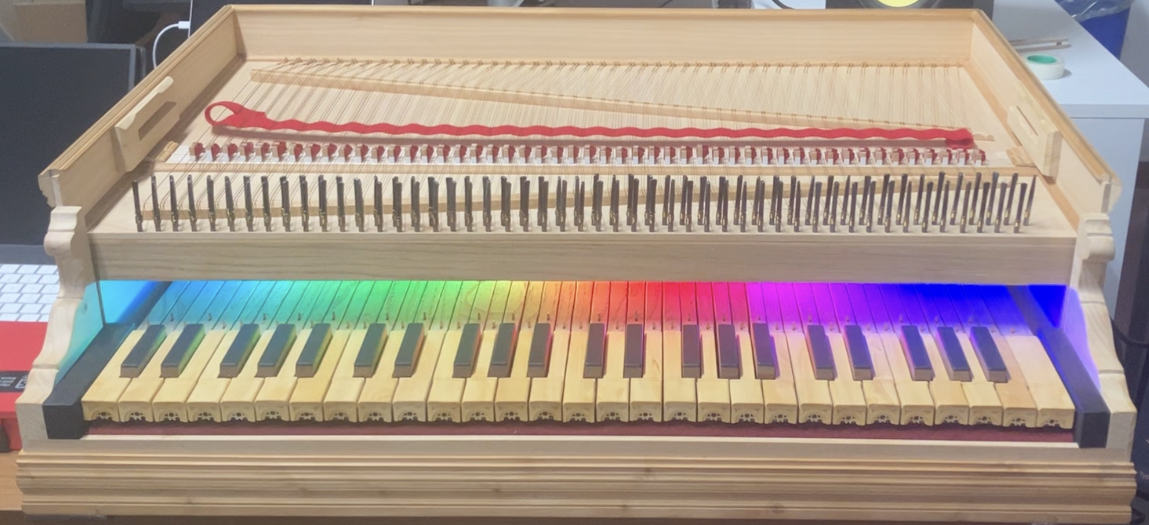
src/images/49-key-leds.png
