Nemus-Project/haptic-harpsichord-nime-2025/src/images/controller-board-v0.1.0.png

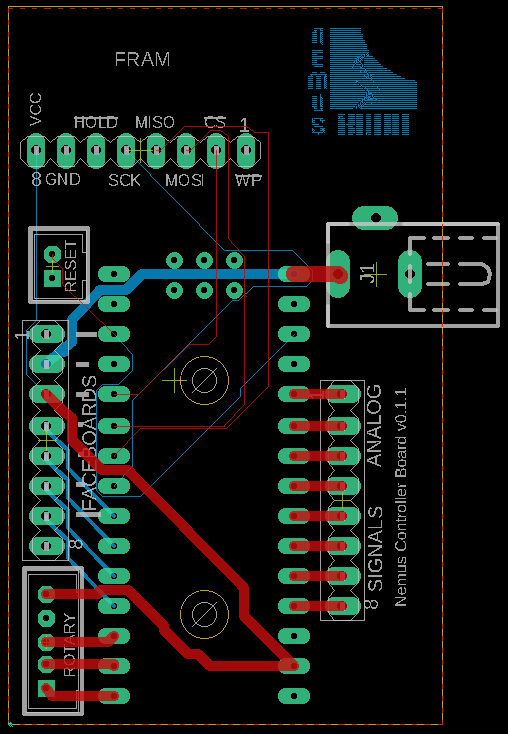
src/images/controller-board-v0.1.0.png
