Nemus-Project/haptic-harpsichord-nime-2025/src/images/exhibition-user-1.jpeg

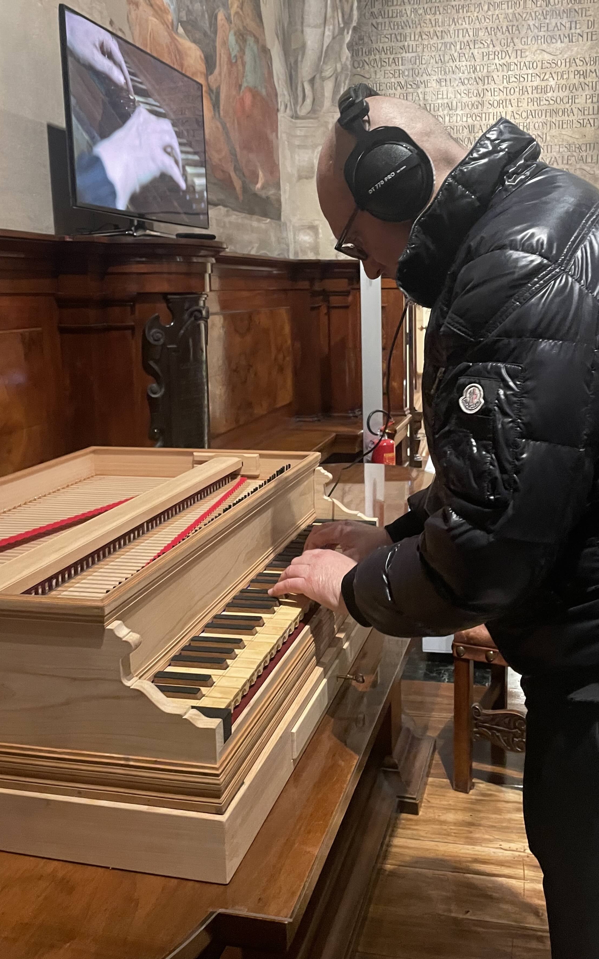
src/images/exhibition-user-1.jpeg
