Nemus-Project/haptic-harpsichord-nime-2025/src/images/exhibition-user-2.jpg

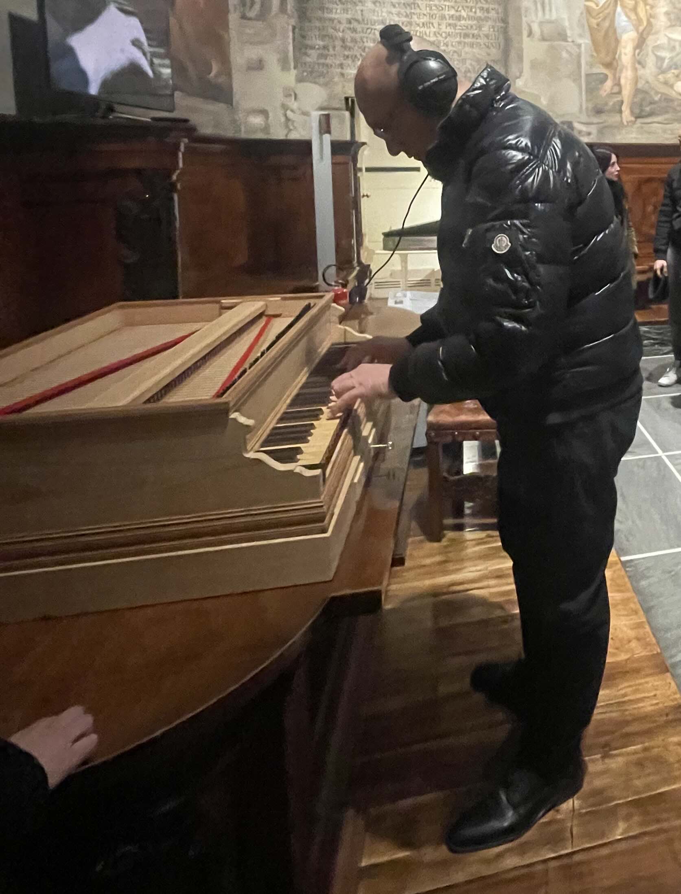
src/images/exhibition-user-2.jpg
