Nemus-Project/haptic-harpsichord-nime-2025/src/images/jack-w-tag.jpeg

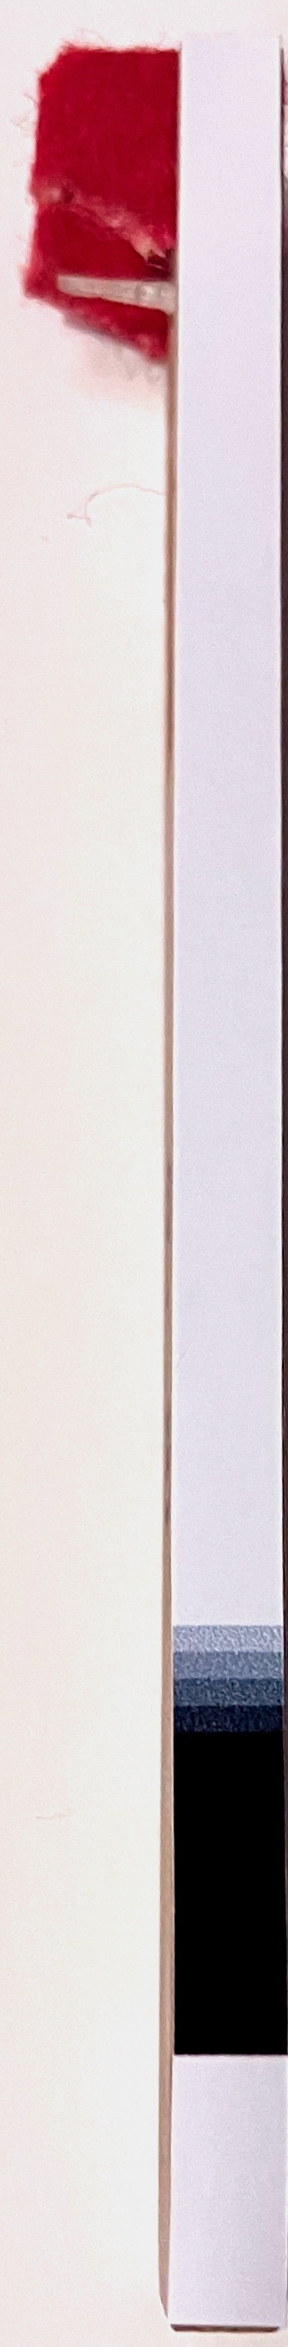
src/images/jack-w-tag.jpeg
