Nemus-Project/haptic-harpsichord-nime-2025/src/images/key_milling_area.jpg

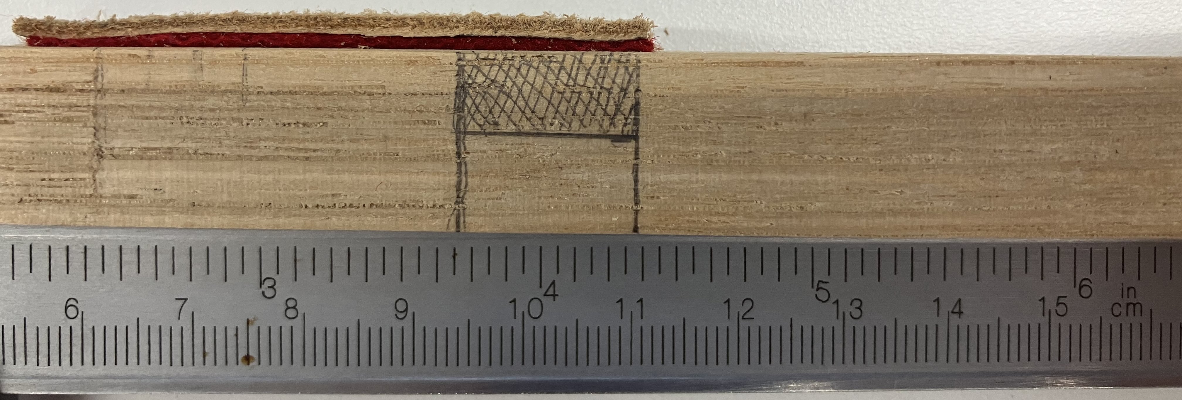
src/images/key_milling_area.jpg
