Nemus-Project/haptic-harpsichord-nime-2025/src/images/keys-milled.jpeg

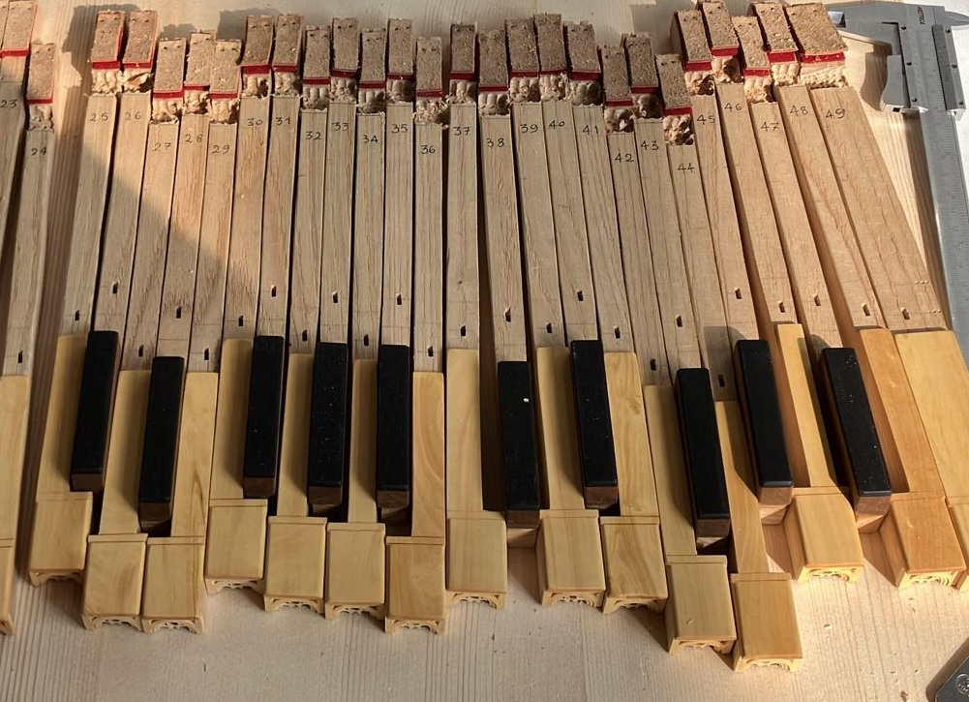
src/images/keys-milled.jpeg
