Nemus-Project/haptic-harpsichord-nime-2025/src/images/milled-keys.jpg

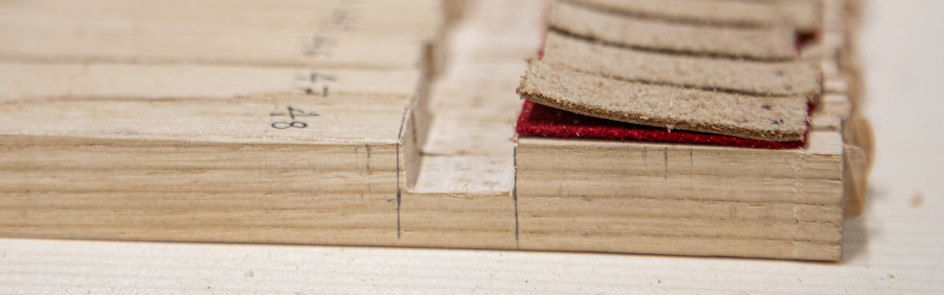
src/images/milled-keys.jpg
