Nemus-Project/haptic-harpsichord-nime-2025/src/images/sensor-board-baffles.jpeg

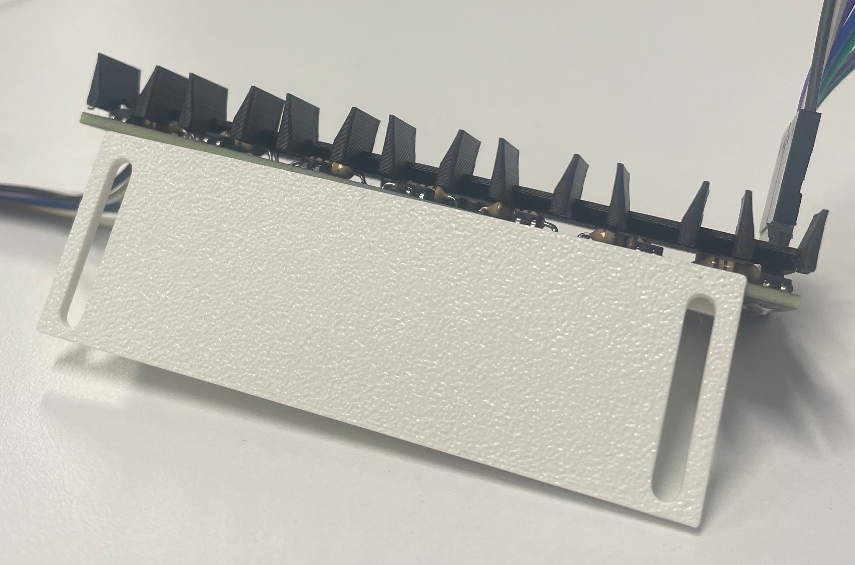
src/images/sensor-board-baffles.jpeg
