Nemus-Project/haptic-harpsichord-nime-2025/src/images/sensor-board-reverse-side-anon.png

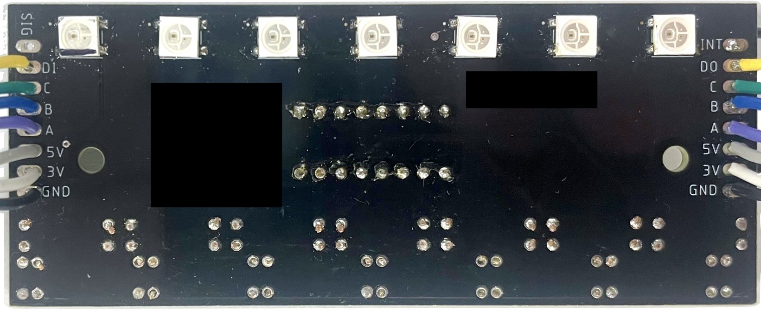
src/images/sensor-board-reverse-side-anon.png
