Nemus-Project/haptic-harpsichord-nime-2025/src/images/sensor-board-reverse-side.jpeg

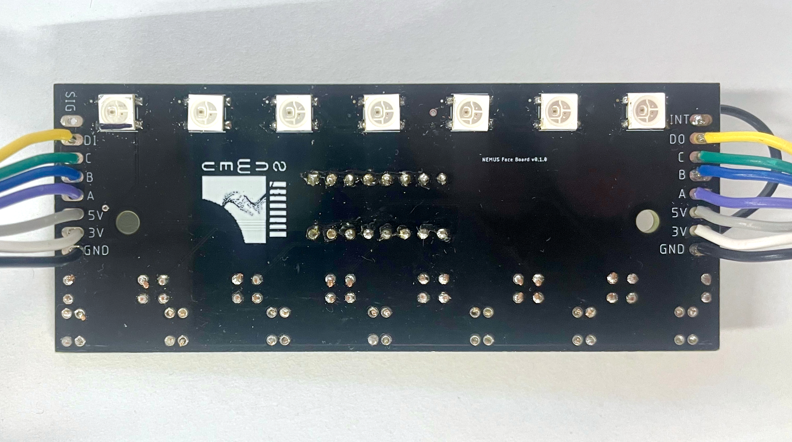
src/images/sensor-board-reverse-side.jpeg
