Nemus-Project/haptic-harpsichord-nime-2025/src/images/sensor-board-w-baffles-detail.jpeg

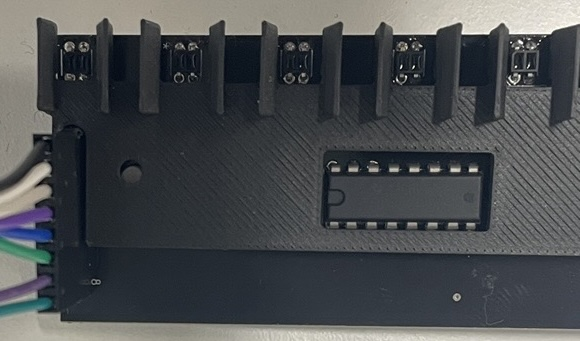
src/images/sensor-board-w-baffles-detail.jpeg
