Nemus-Project/haptic-harpsichord-nime-2025/src/images/sensors-without-keys-front.jpg

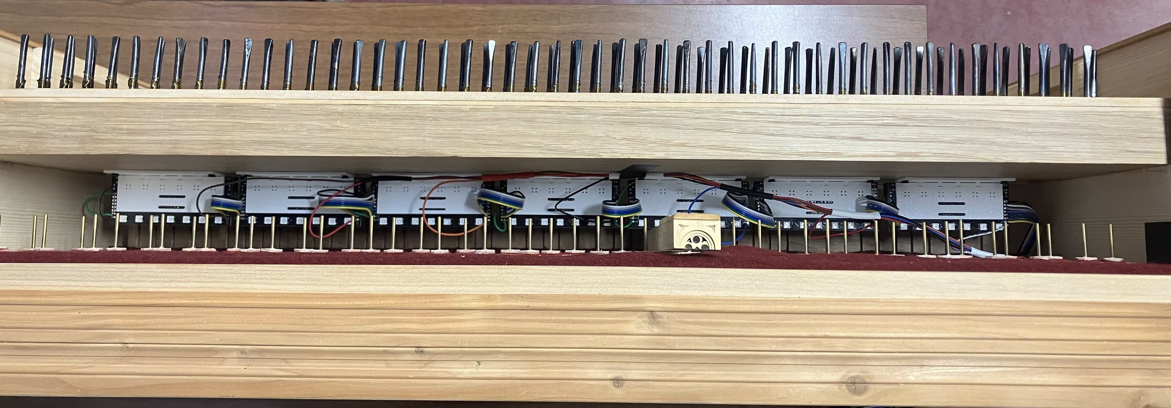
src/images/sensors-without-keys-front.jpg
