Nemus-Project/haptic-harpsichord-nime-2025/src/images/serial_monitor.png

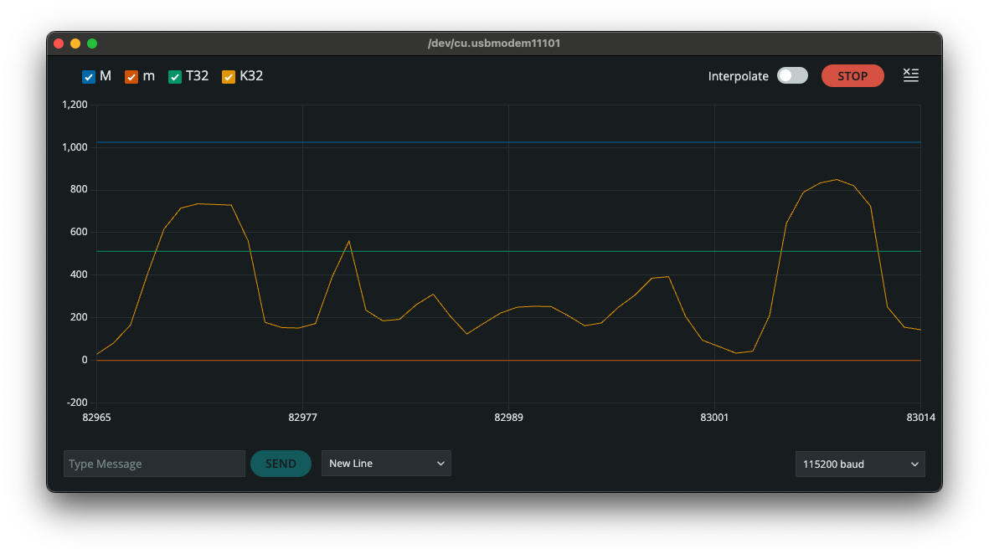
src/images/serial_monitor.png
