Nemus-Project/haptic-harpsichord-nime-2025/src/images/system-block-diagram-long.png

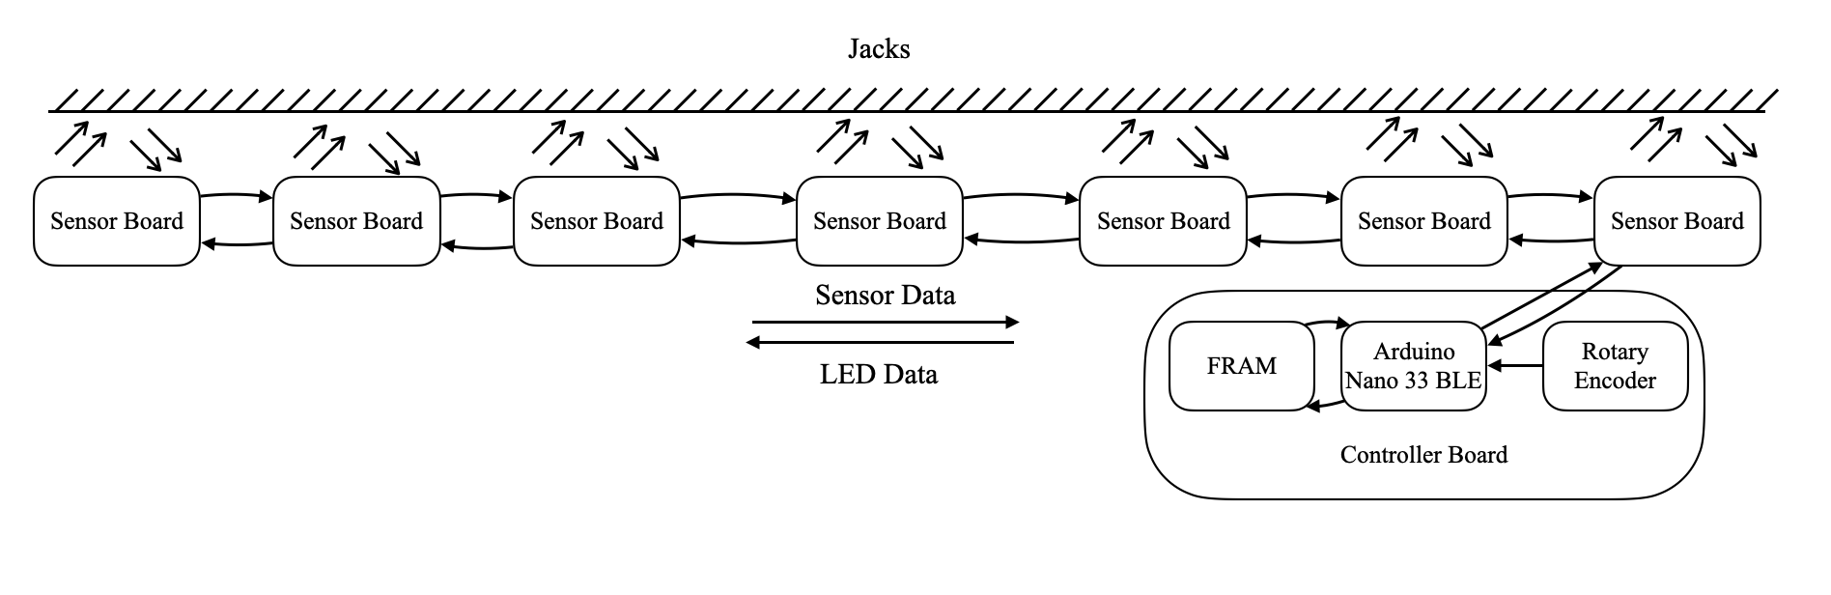
src/images/system-block-diagram-long.png
