Nemus-Project/haptic-harpsichord-nime-2025/src/images/system-block-diagram.png

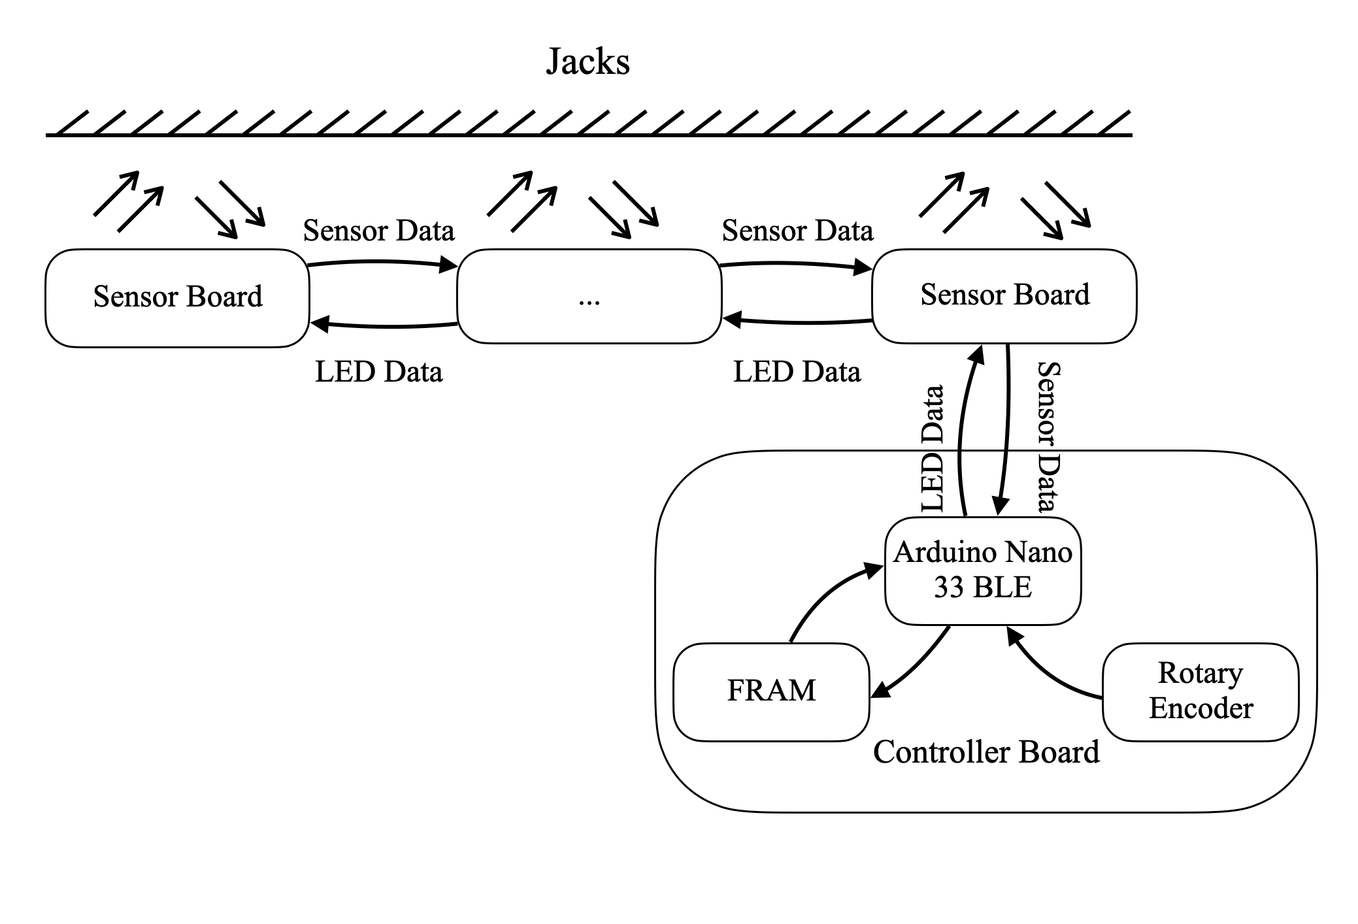
src/images/system-block-diagram.png
