Nemus-Project/haptic-harpsichord-nime-2025/src/images/tagging-jacks-1.jpg

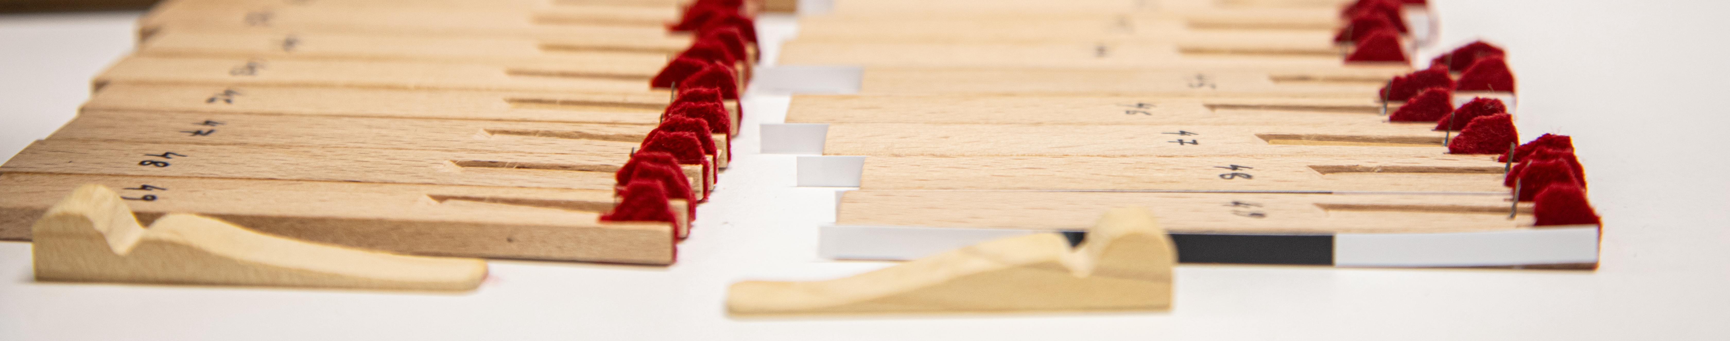
src/images/tagging-jacks-1.jpg
