Nemus-Project/haptic-harpsichord-nime-2025/src/images/trasuntino-log-harp.jpg

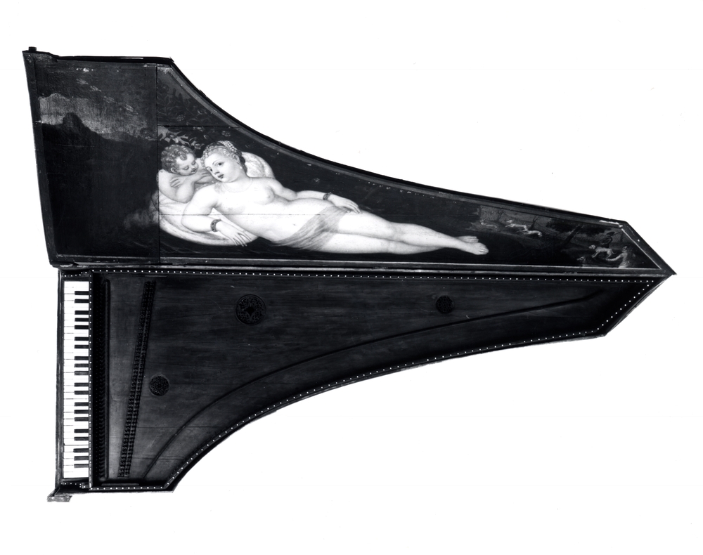
src/images/trasuntino-log-harp.jpg
