Nemus-Project/haptic-harpsichord-nime-2025/src/images/controller-board-v0.1.0.dxf

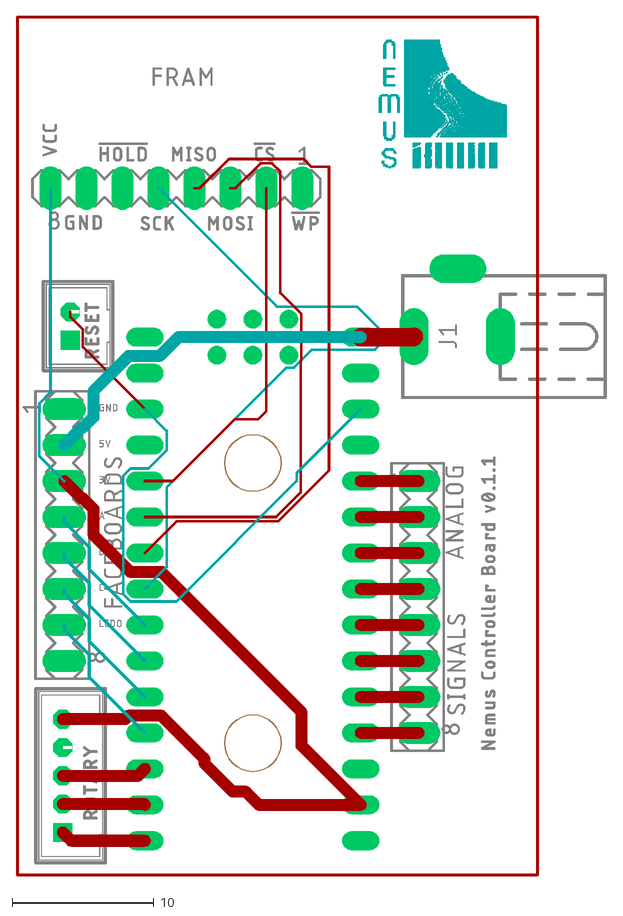
[picture p48: CAD file, 2025-01-07]
src/images/controller-board-v0.1.0.dxf
41.7 x 60.7
