Nemus-Project/haptic-harpsichord-nime-2025/src/images/3-sensor-schematic.dxf

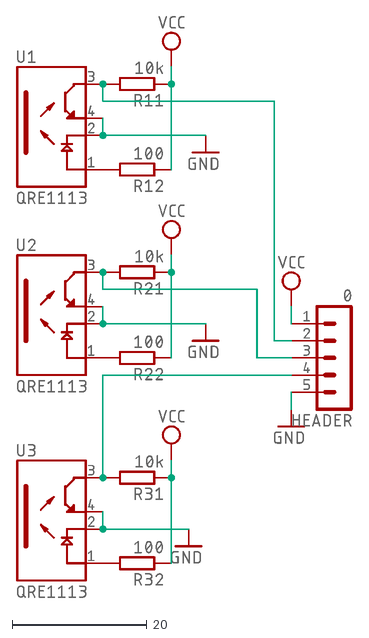
[picture p49: CAD file, 2025-01-07]
src/images/3-sensor-schematic.dxf
49.9 x 86.2
