Nemus-Project/haptic-harpsichord-nime-2025/src/images/7-sensor-board-v0.1.0.dxf

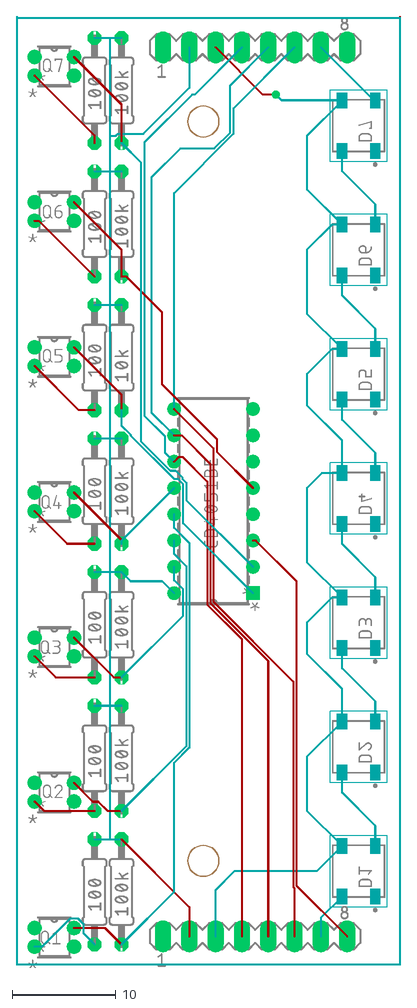
[picture p50: CAD file, 2025-01-07]
src/images/7-sensor-board-v0.1.0.dxf
37.2 x 91.9
