Nemus-Project/haptic-harpsichord-nime-2025/src/images/block-diagram-2.pdf

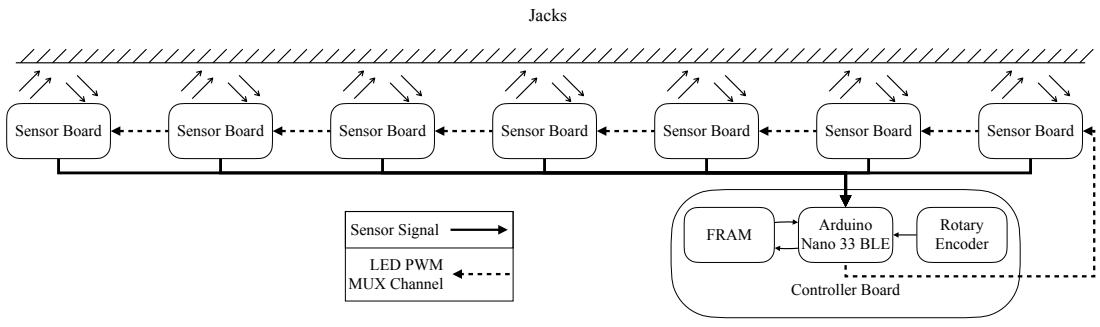
[picture p51: page 1]
Controller Board; FRAM; Rotary; Encoder; Arduino Nano 33 BLE; Sensor Board; LED PWM MUX Channel; Sensor Signal; Jacks
