Nemus-Project/haptic-harpsichord-nime-2025/src/images/block-diagram.pdf

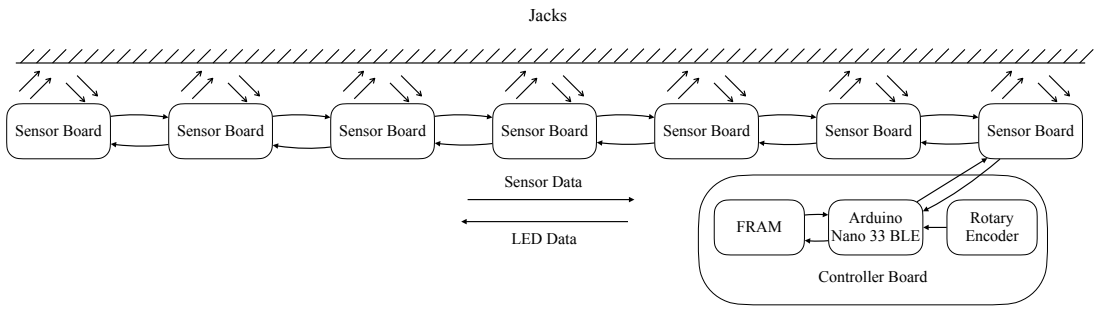
[picture p52: page 1]
Controller Board; FRAM; Rotary; Encoder; Arduino Nano 33 BLE; Sensor Board; LED Data; Sensor Data; Jacks
