Nemus-Project/haptic-harpsichord-nime-2025/(commit log)

2025-01-07 add pcb cad images
    [3-sensor-schematic.dxf, 7-sensor-board-v0.1.0.dxf, controller-board-v0.1.0.dxf]
2025-01-15 move images to src/
    [3-sensor-schematic.dxf, 7-sensor-board-v0.1.0.dxf, controller-board-v0.1.0.dxf]
2025-01-20 milled keys images
2025-02-03 add reverse sensor board images
